ipeet/mte481/README

MTE 481 - Design Project

Authors:
Iain Peet
Rowan Head-Marsden
Jordan Valentin

Overview:
Object avoidance and, potentially, localization and maping for powered wheelchairs.
