ipeet/mte481/Poster/FYDP_Poster.pdf

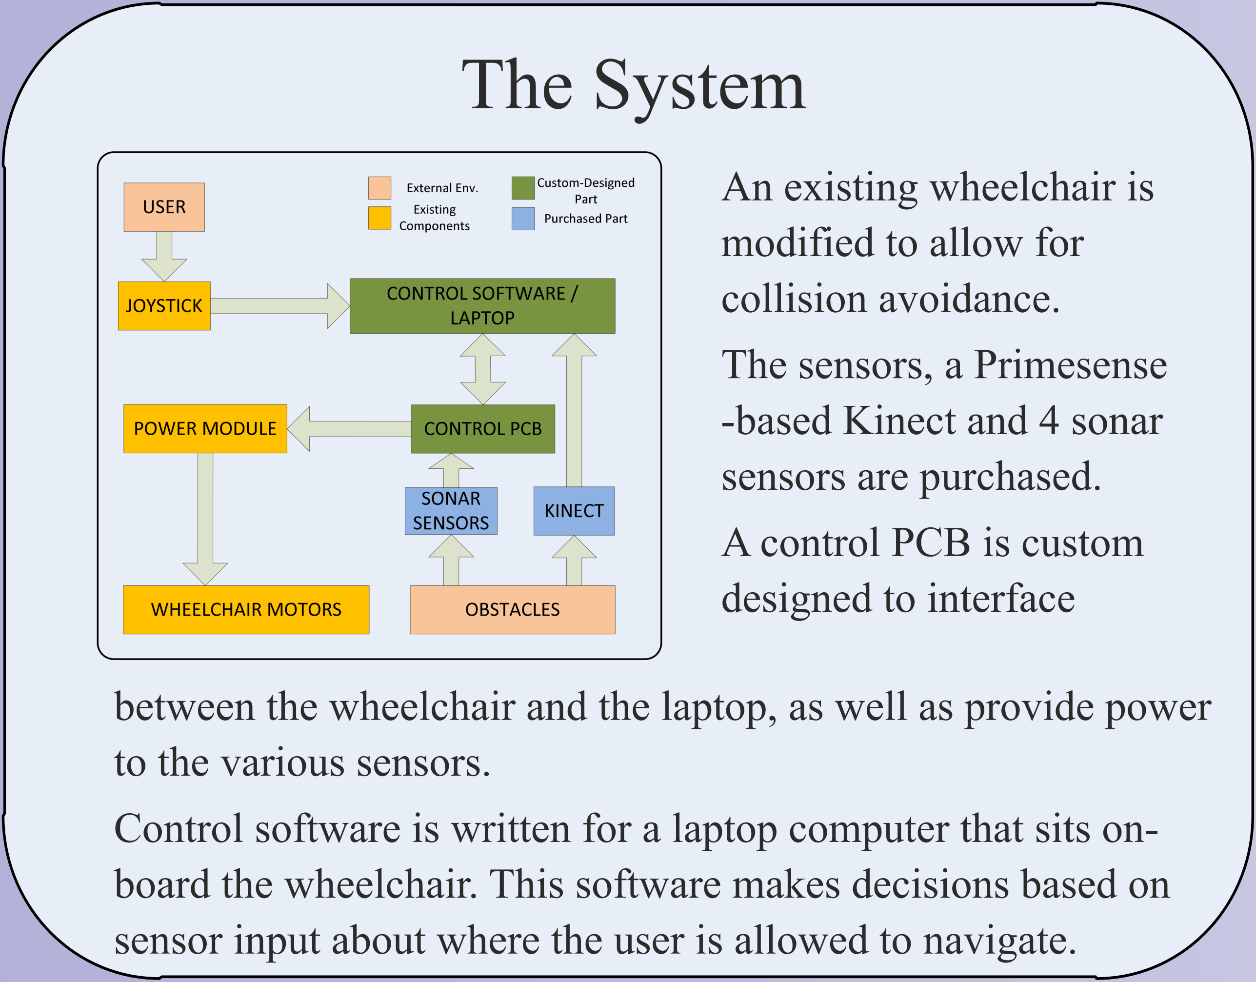
[picture p46: figure]
The System; An existing wheelchair is modified to allow for collision avoidance.; The sensors, a Primesense -based Kinect and 4 sonar sensors are purchased.; A control PCB is custom designed to interface; to the various sensors.
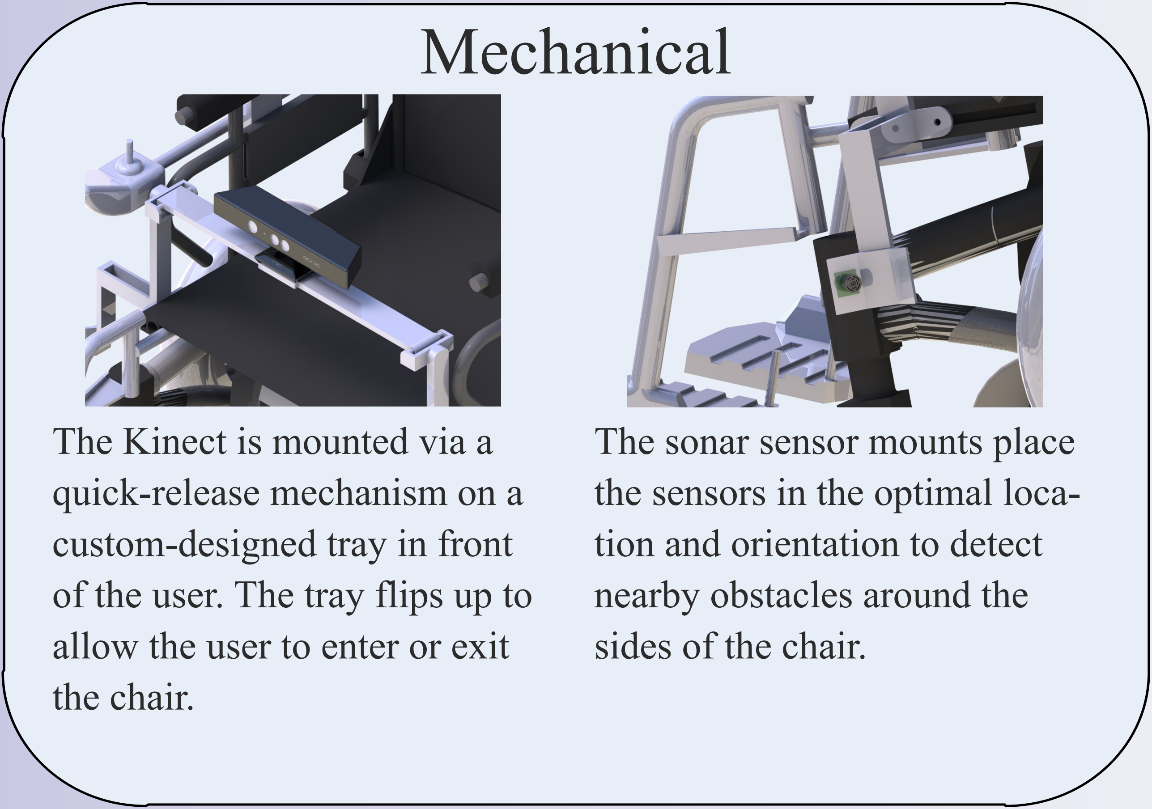
[picture p47: figure]
Mechanical; The Kinect is mounted via a quick-release mechanism on a custom-designed tray in front of the user. The tray flips up to allow the user to enter or exit the chair.; The sonar sensor mounts place the sensors in the optimal loca- tion and orientation to detect nearby obstacles around the sides of the chair.

A visualization of the wheelchair moving down a hallway. Obstacles are represented by white tiles. Requested path in green/red, where the green portion is collisionfree and will be allowed by the software.

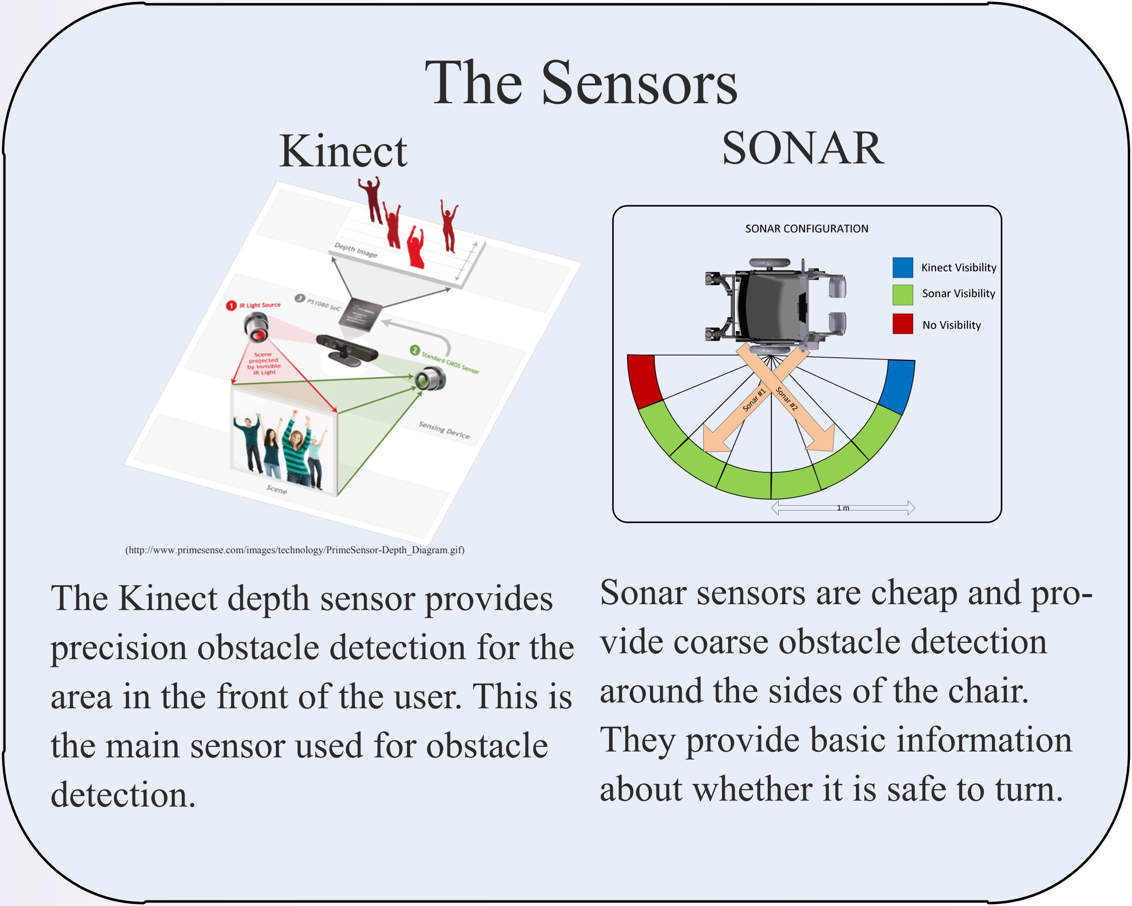
[picture p48: figure]
The Sensors; Kinect; SONAR; The Kinect depth sensor provides precision obstacle detection for the area in the front of the user. This is the main sensor used for obstacle detection.; Sonar sensors are cheap and pro- vide coarse obstacle detection around the sides of the chair. They provide basic information about whether it is safe to turn.; (http://www.primesense.com/images/technology/PrimeSensor-Depth_Diagram.gif)
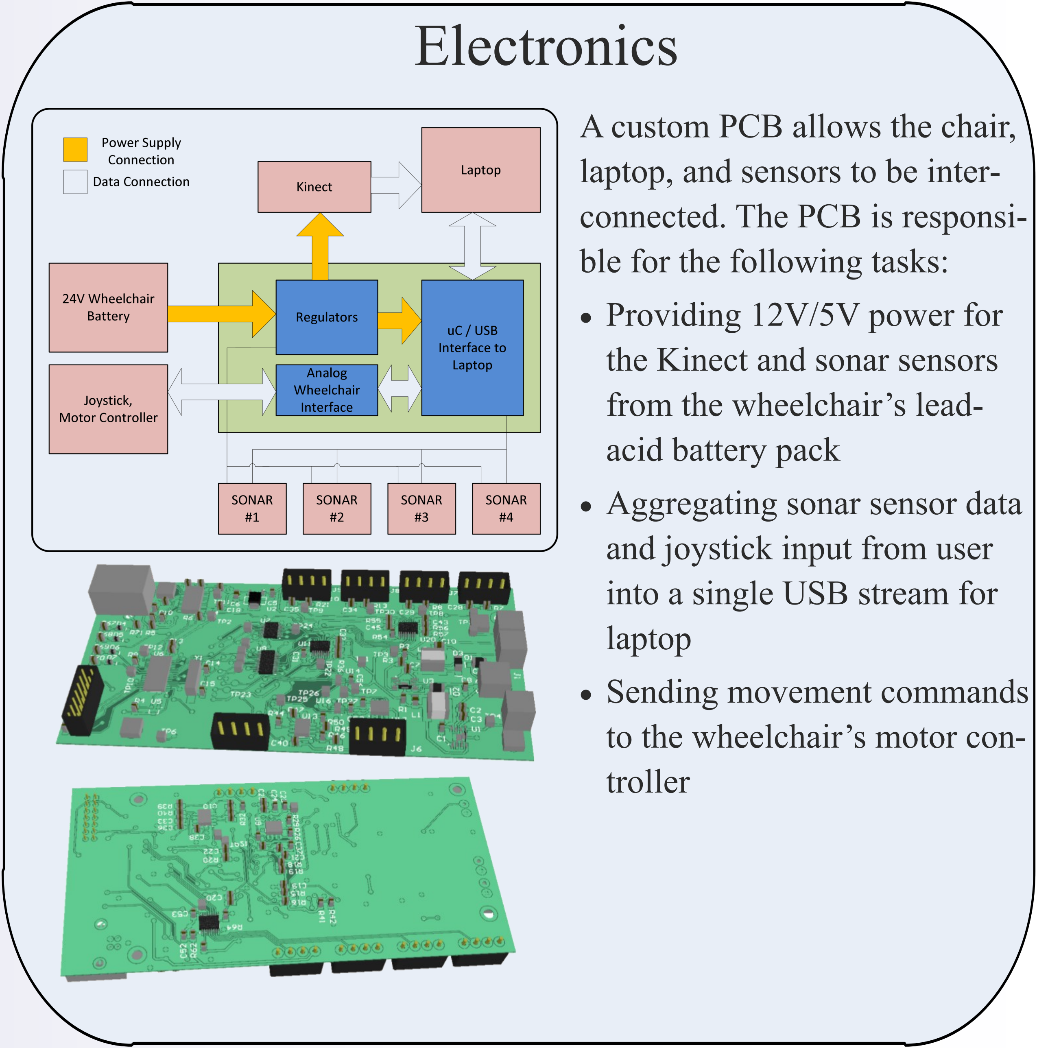
[picture p49: figure]
Electronics; A custom PCB allows the chair, laptop, and sensors to be inter- connected. The PCB is responsi- ble for the following tasks:; Providing 12V/5V power for the Kinect and sonar sensors from the wheelchair’s lead- acid battery pack; Aggregating sonar sensor data and joystick input from user into a single USB stream for laptop; Sending movement commands to the wheelchair’s motor con- troller

# Acknowledgements

Special thanks to Professor Amir Khajepour of the MME Dept. for providing a powered wheelchair for the duration of this project.

## Collision Avoidance System for a Powered Wheelchair

# MTE 482 — Group #2

### Rowan Head-Marsden, Iain Peet, Jordan Valentin

# The Need

# Our Objectives

Powered wheelchairs can greatly improve the mobility and independence of the disabled, but many potential users in care homes are denied access due to safety concerns. Collision avoidance systems are needed for powered chairs to increase safety and allow many more people access to the enhanced quality of life they can provide.

Provide a low-cost system to the end-user — Cost is sensitive to many potential users and powered chairs are expensive enough as it is
Effective collision avoidance — Must be a very dependable system for care homes to consider allowing patients access Integrates with an existing wheelchair model — No need to redesign from scratch

# Software

between the wheelchair and the laptop, as well as provide power

Control software is written for a laptop computer that sits onboard the wheelchair. This software makes decisions based on sensor input about where the user is allowed to navigate.

The software takes the Kinect and sonar input about obstacles in the environment and user commands entered via the joystick. Combined with a model of the wheelchair the path of the chair is predicted and collision checking performed. Movement of the chair is limited based on these collision checks.
