ipeet/mte481/doc/pdp/pdp.pdf

## MTE 481 - Design Project

Object Avoidance and Navigation for Powered Wheelchairs

Iain Peet | Rowan Head-Marsden | Jordan Valentin

October 3, 2011

## Introduction


## Need Statement

Powered wheelchairs can improve the mobility of the physically handicapped, but alertness and control are required for safe operation. Additional assistive technology is needed in order to afford the same benefits to the more severely disabled.

## Objectives & Constraints

I Improve the safety of powered wheelchairs, for the occupand and for nearby pedestrians.

I Make powered wheelchairs accessible to people who would otherwise be denied due to safety concerns.
I Assist wheelchair users with difficult tasks, such as precise positioning and movement in constrained spaces.
I Avoid requiring a specialized, controlled operating environment.
I It must be possible to integrate with existing wheelchairs.

## Criteria

I Risk of human harm.
I Tolerance of human error.

I Robustness against physical damage.
I Ability to operate in a variety of environments.

I Price.
I Electrical power consumption.

## Design Concept

I Use sensor(s) as inputs to a computer-controlled system.

I Take user input into this system.
I Combine the user input and sensor readings to determine output to motor controllers.
I Produce collision-free movement of chair (whether by warnings, automated avoidance, etc.)

## Stereo Vision


## Ultrasonic


## Infra-Red


## RADAR

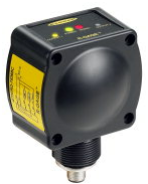
[picture p50: figure]

## LIDAR


## Microsoft Kinect


## Patent Search

“Computer controlled power wheelchair navigation system”


I Patent No. US 7,383,107 B2 (June 3, 2008)

## Patent Search

“Powered Wheelchair”


I Patent No. US 2010/0082182 A1 (April 1, 2010)

## Patent Search

“Wheelchair and method for correcting the guidance of a wheelchair”


I Patent No. US 2011/0130940 A1 (June 2, 2011)

# Questions?
