ipeet/mte481/doc/final/images/FinalSonarMount2.JPG

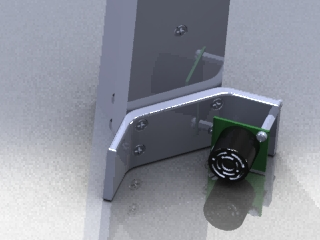
doc/final/images/FinalSonarMount2.JPG
