ipeet/mte481/doc/final/images/FinalSonarMount.jpg

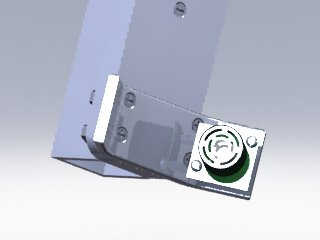
doc/final/images/FinalSonarMount.jpg
