ipeet/mte481/doc/final/images/SONAR_RENDER.png

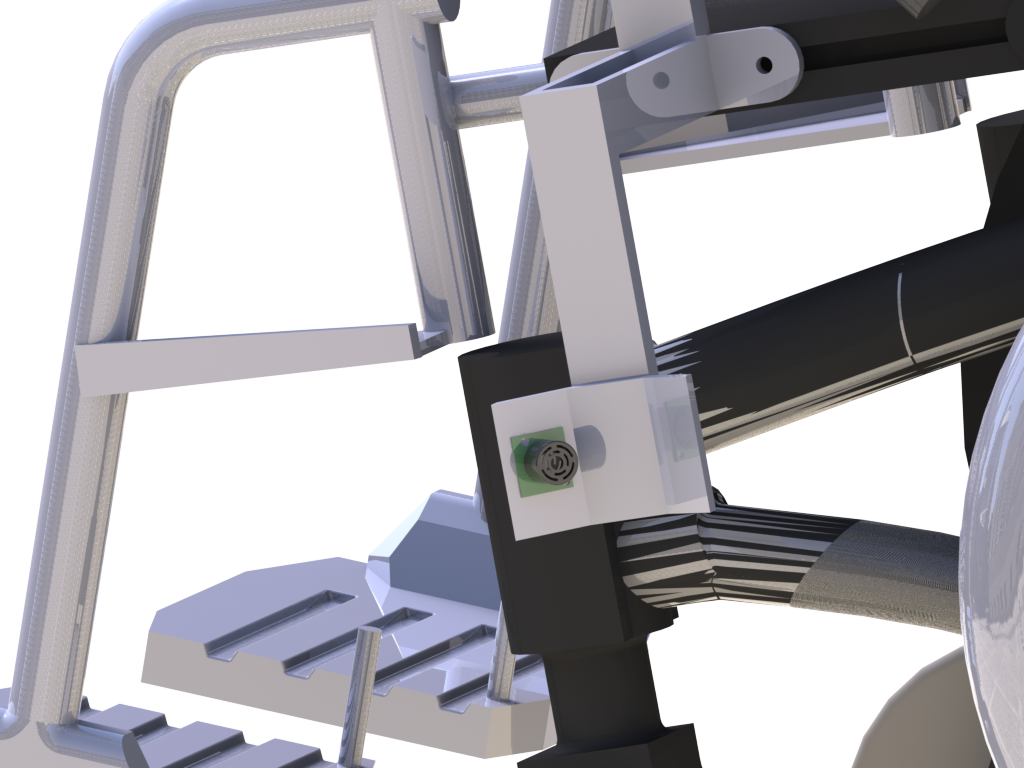
doc/final/images/SONAR_RENDER.png
