ipeet/mte481/doc/final/images/System_Level.png

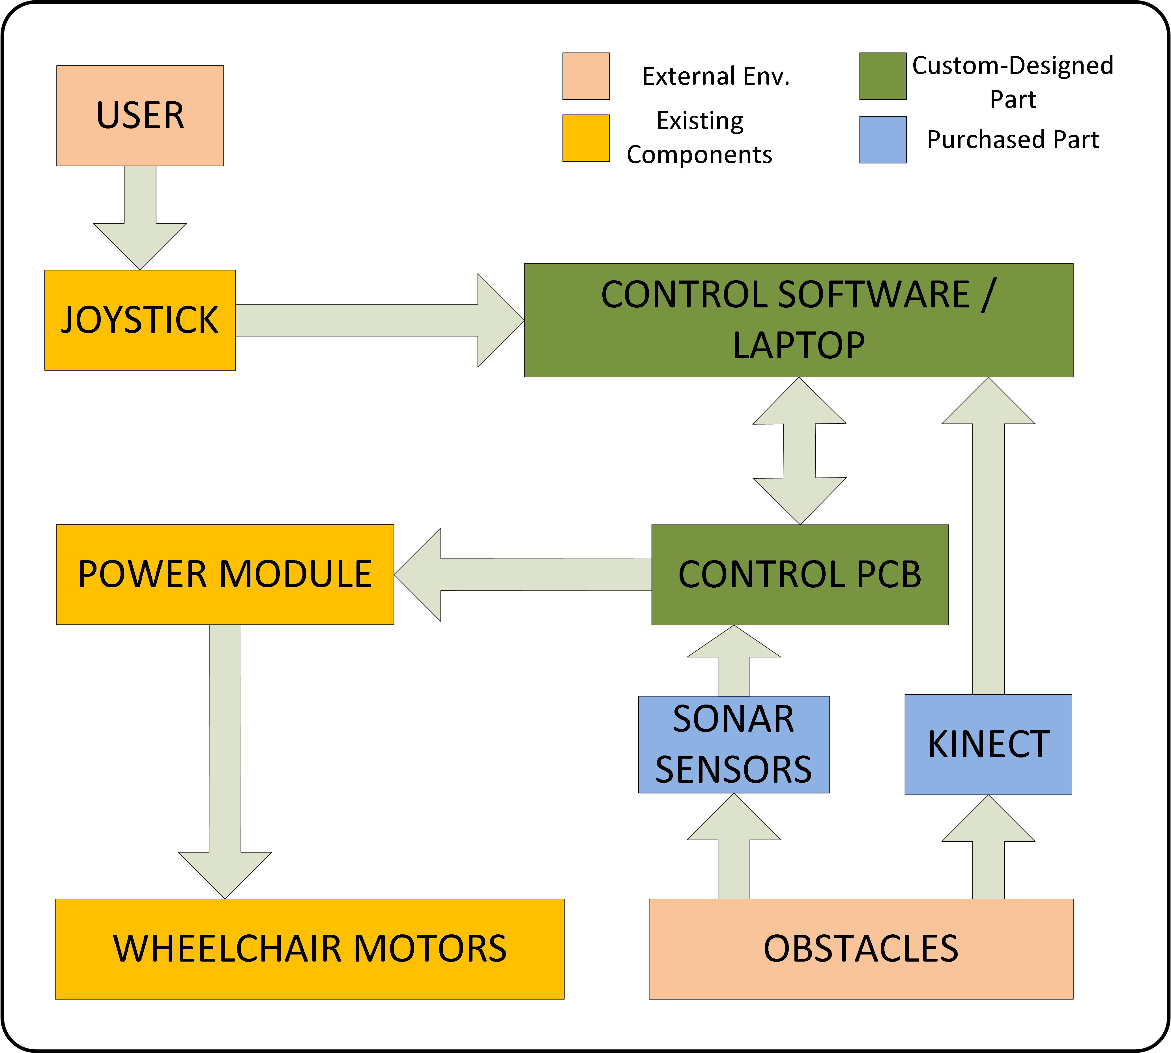
doc/final/images/System_Level.png
