ipeet/mte481/doc/report/images/SonarSensor.jpg

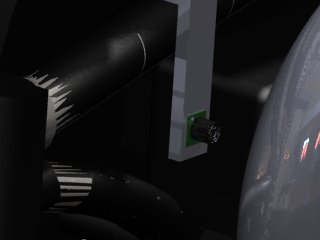
doc/report/images/SonarSensor.jpg
