ipeet/mte481/doc/report/images/WheelChair_CAD.jpg

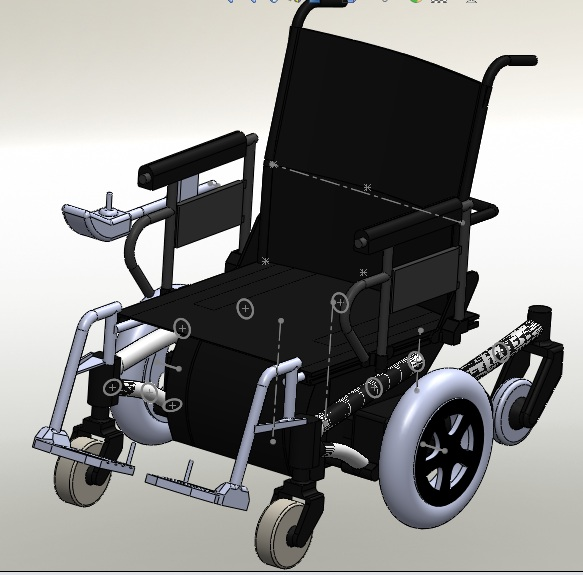
doc/report/images/WheelChair_CAD.jpg
