ipeet/mte481/doc/final/source docs/BOM_Final.xlsx

Sheet: 1U
Part | Count | Cost | Total
Xbox Kinect | 1 | 146.89 | $146.89
Xbox Kinect Mount | 1 | 30 | $30
Sonar Sensor | 4 | 34.59 | $138.36
Sheet Metal (sq ft) | 1 | 50 | $50
PCB | 1 | 72 | $72
PCB Components | 1 | 43.5 | $43.5
Basic Netbook | 1 | 350 | $350
Total |  |  | $830.75

Sheet: 1KU
Part | Count | Cost | Total
Xbox Kinect | 1 | 146.89 | $146.89
Xbox Kinect Mount | 1 | 30 | $30
Sonar Sensor | 4 | 34.59 | $138.36
Sheet Metal (sq ft) | 1 | 50 | $50
PCB | 1 | 10 | $10
PCB Components | 1 | 20 | $20
High-Level Processor | 1 | 35 | $35
Total |  |  | $430.25
