ipeet/mte481/doc/report/source_documents/BOM.xlsx

Part | Count | Cost | Total
Xbox Kinect | 1 | 150 | $150
Xbox Kinect Mount | 1 | 15 | $15
Sonar Sensor | 4 | 30 | $120
Sheet Metal (sq foot) | 4 | 3 | $12
Spacers | 8 | 0.25 | $2
PCB + Components | 1 | 150 | $120
Basic Netbook | 1 | 350 | $350
Total |  |  | $769
