ipeet/mte481/wheelChair_Model/Wheel Chair.SLDASM

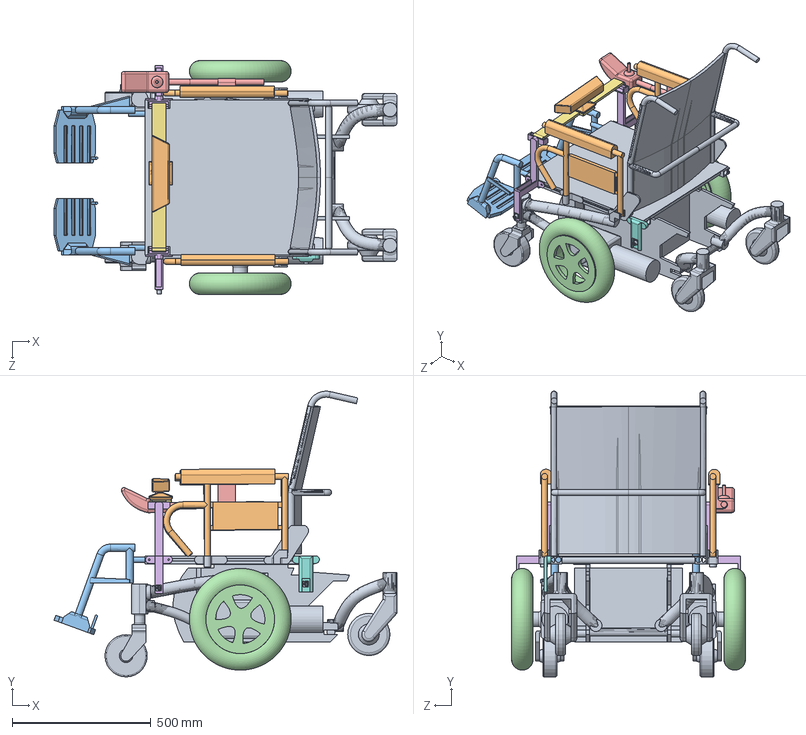
[picture p57: CAD file, 2012-03-24]
wheelChair_Model/Wheel Chair.SLDASM
1237.0 x 1031.0 x 844.0 mm
Wheel Chair Chair
Wheel Chair Arms x 2
Wheel Chair foot Rest Left
Wheel Chair Wheel x 2
Wheel Chair Controller
Right End x 2
Table
Left End
Sonar Sensor x 2
Kinect
