ipeet/mte481/wheelChair_Model/Wheel Chair Model2.SLDASM

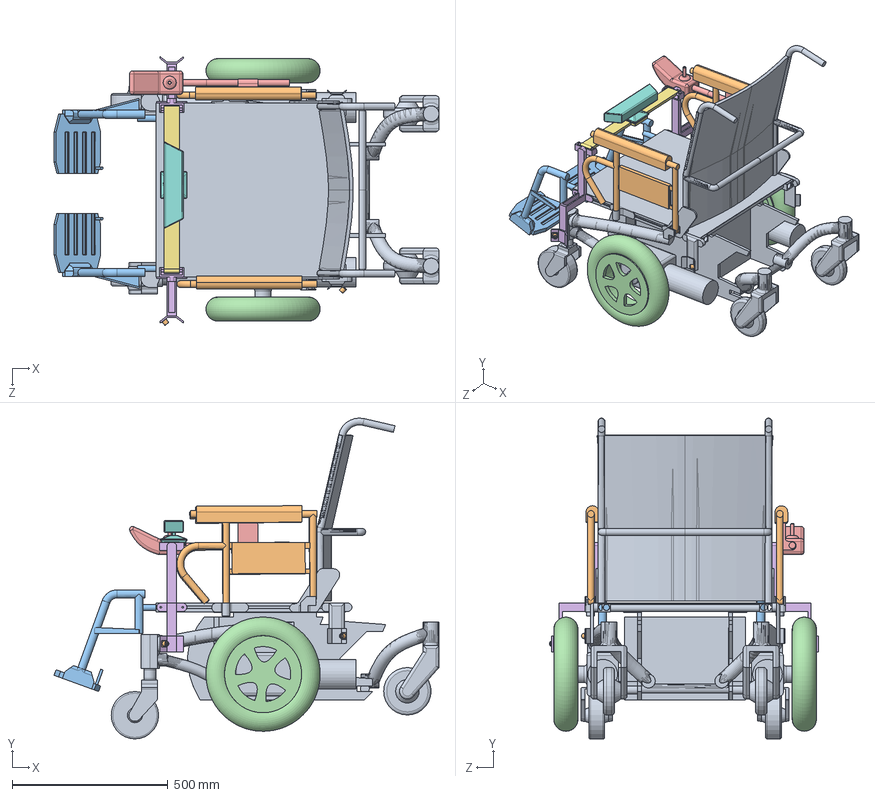
[picture p58: CAD file, 2012-03-24]
wheelChair_Model/Wheel Chair Model2.SLDASM
1237.0 x 1031.0 x 864.1 mm
Wheel Chair Chair
Wheel Chair Arms x 2
Wheel Chair foot Rest Left
Wheel Chair Wheel x 2
Wheel Chair Controller
Right End x 2
Table
Kinect
Left End x 2
Sonar Sensor x 2
