ipeet/mte481/wheelChair_Model/Wheel Chair2.SLDASM

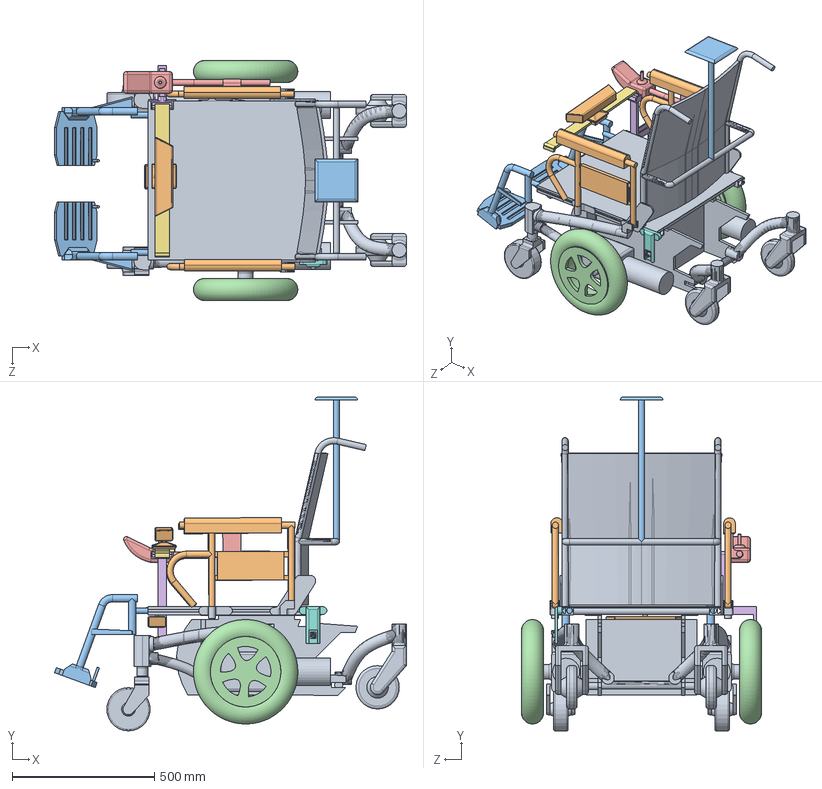
[picture p59: CAD file, 2012-03-24]
wheelChair_Model/Wheel Chair2.SLDASM
1237.0 x 1173.3 x 844.0 mm
Wheel Chair Chair
Wheel Chair Arms x 2
Wheel Chair foot Rest Left
Wheel Chair Wheel x 2
Wheel Chair Controller
Kinect
