ipeet/mte481/wheelChair_Model/RPM1.SLDPRT

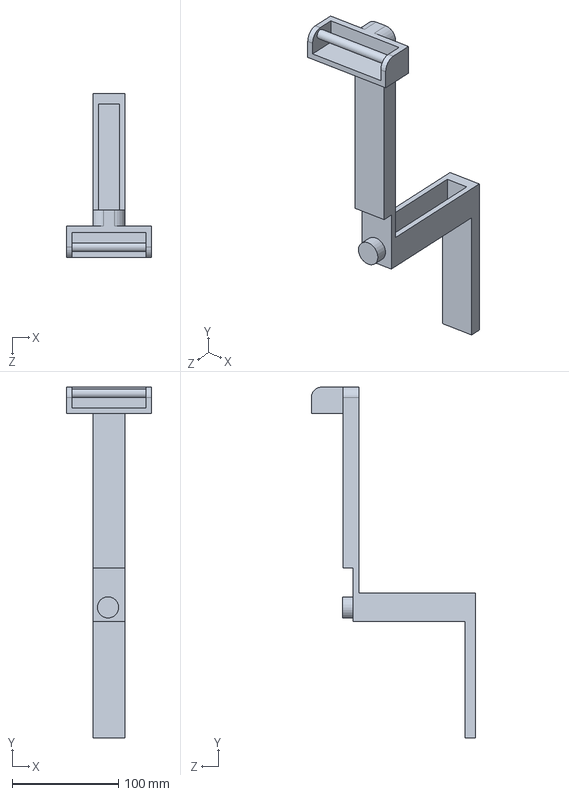
[picture p60: CAD file, 2012-03-24]
wheelChair_Model/RPM1.SLDPRT
80.0 x 330.8 x 155.0 mm
