ipeet/mte481/wheelChair_Model/Wheel Chair Wheel.SLDPRT

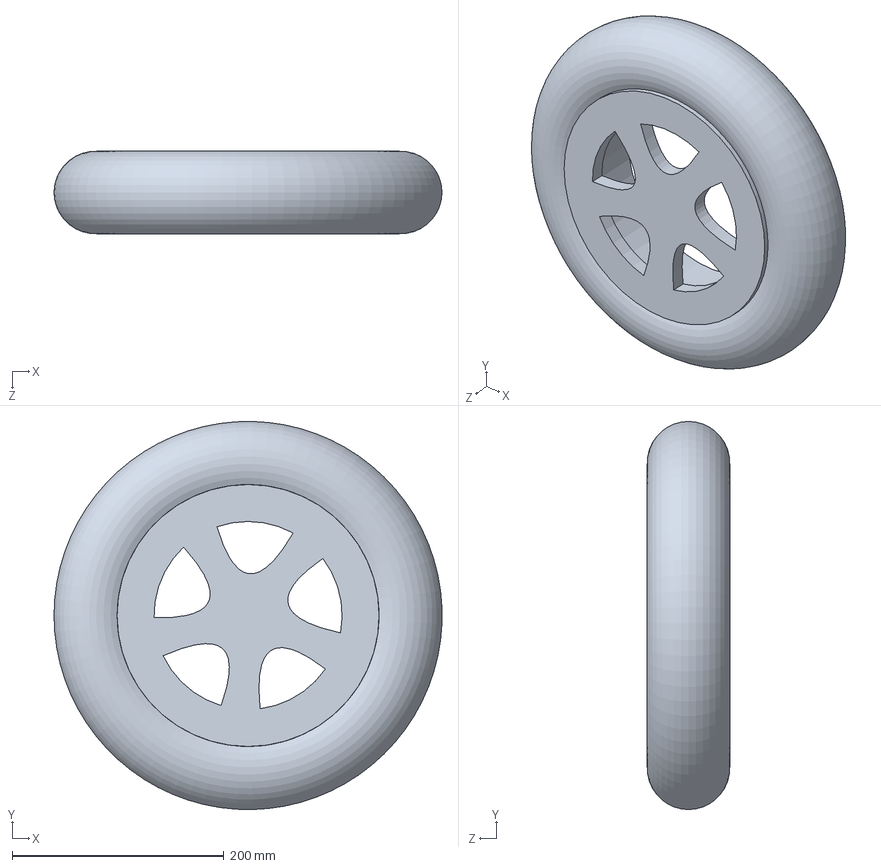
[picture p61: CAD file, 2012-03-24]
wheelChair_Model/Wheel Chair Wheel.SLDPRT
366.8 x 366.9 x 78.0 mm
