ipeet/mte481/wheelChair_Model/Table.SLDPRT

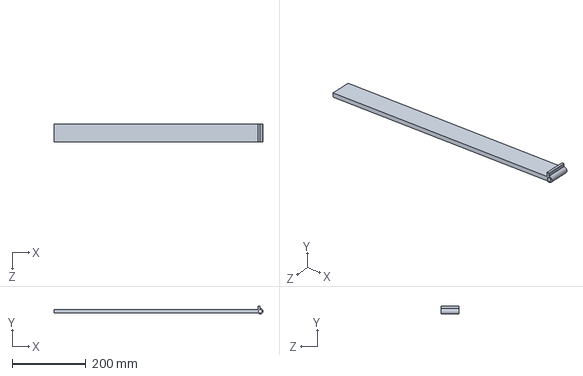
[picture p62: CAD file, 2012-03-24]
wheelChair_Model/Table.SLDPRT
566.3 x 22.0 x 50.0 mm
