ipeet/mte481/wheelChair_Model/Right End.SLDPRT

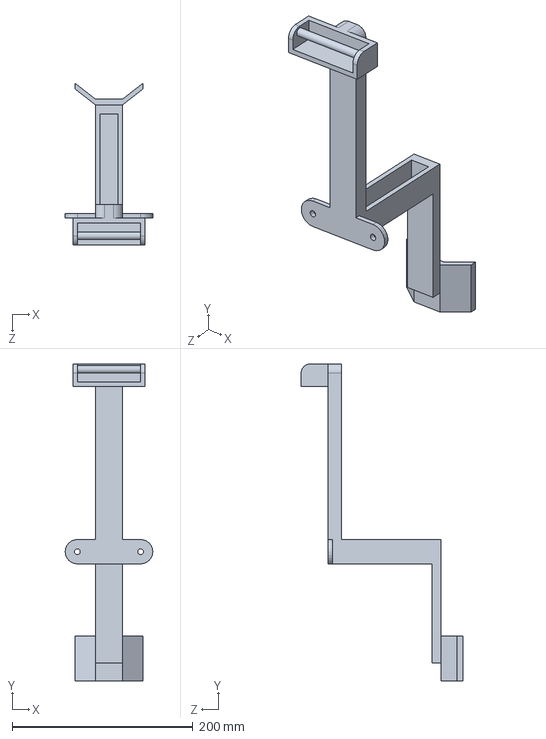
[picture p63: CAD file, 2012-03-24]
wheelChair_Model/Right End.SLDPRT
97.0 x 350.8 x 179.1 mm
