ipeet/mte481/wheelChair_Model/Left End.SLDPRT

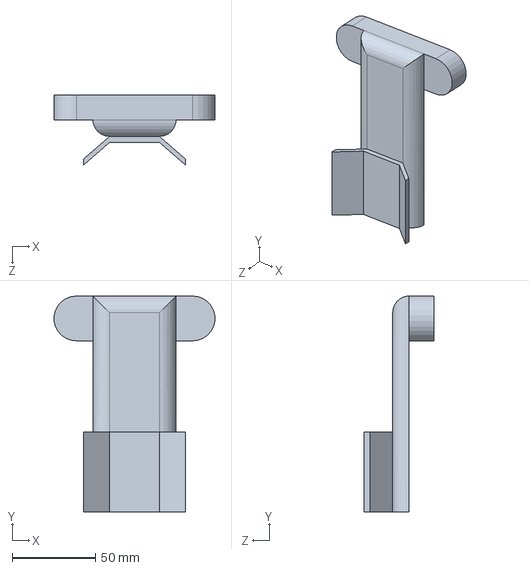
[picture p64: CAD file, 2012-03-24]
wheelChair_Model/Left End.SLDPRT
96.8 x 130.0 x 42.3 mm
