ipeet/mte481/wheelChair_Model/Wheel Chair foot Rest Left.SLDPRT

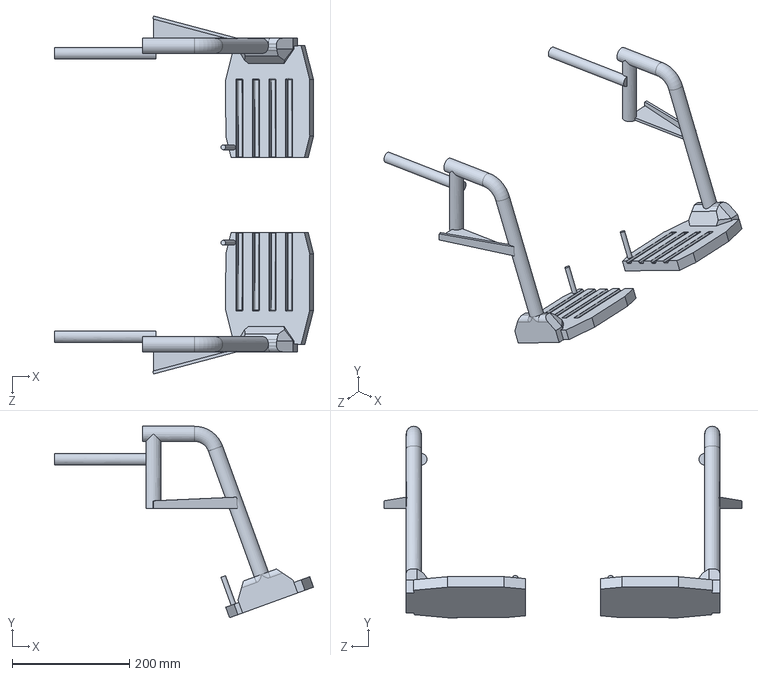
[picture p65: CAD file, 2012-03-24]
wheelChair_Model/Wheel Chair foot Rest Left.SLDPRT
442.0 x 326.6 x 610.6 mm
