ipeet/mte481/wheelChair_Model/Wheel Chair Controller.SLDPRT

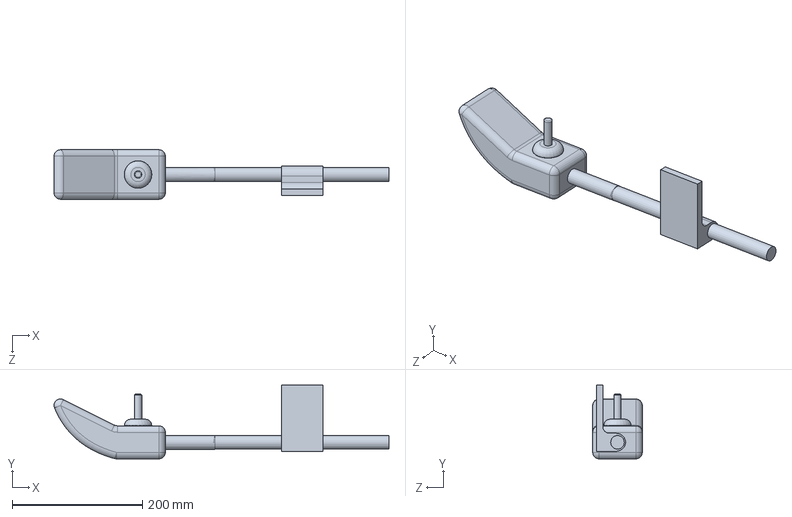
[picture p66: CAD file, 2012-03-24]
wheelChair_Model/Wheel Chair Controller.SLDPRT
513.8 x 113.2 x 76.2 mm
