ipeet/mte481/wheelChair_Model/Sonar Sensor.SLDPRT

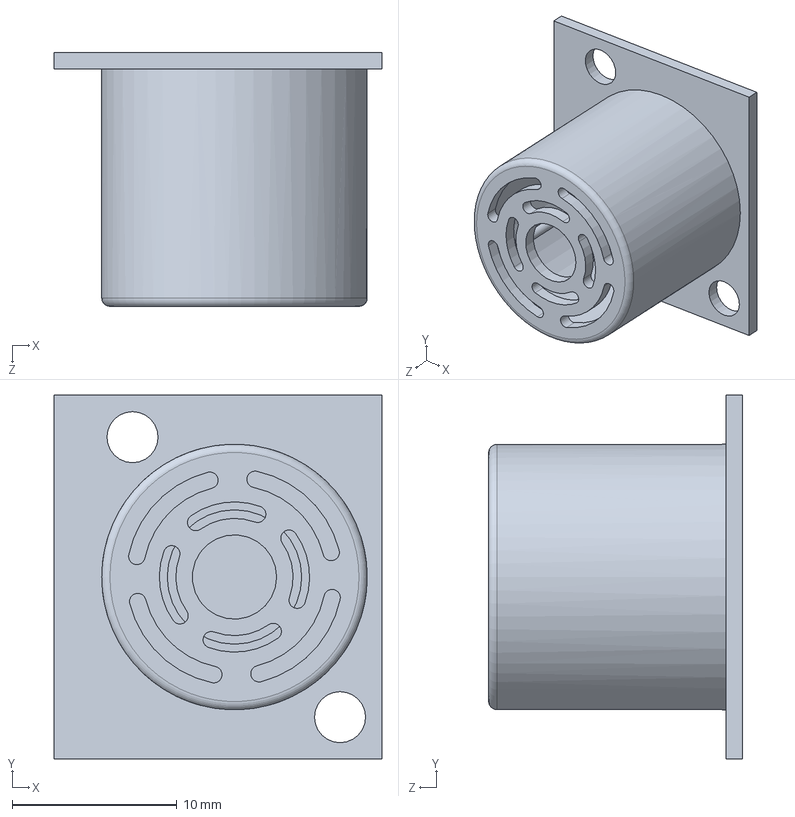
[picture p67: CAD file, 2012-03-24]
wheelChair_Model/Sonar Sensor.SLDPRT
19.9 x 22.1 x 15.4 mm
