ipeet/mte481/wheelChair_Model/Wheel Chair Arms.SLDPRT

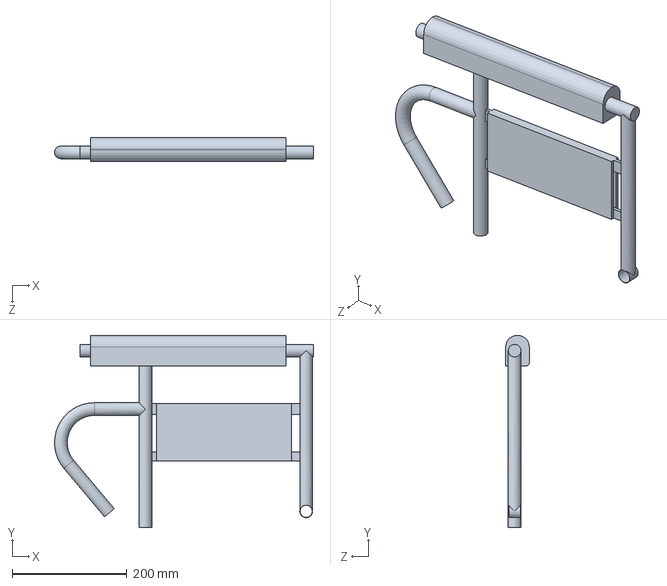
[picture p68: CAD file, 2012-03-24]
wheelChair_Model/Wheel Chair Arms.SLDPRT
450.5 x 334.4 x 41.2 mm
