ipeet/mte481/wheelChair_Model/RPM2.SLDPRT

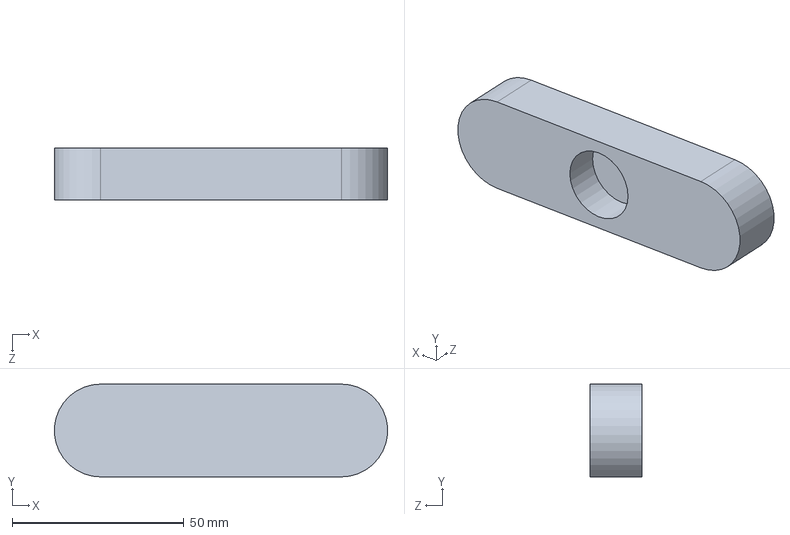
[picture p69: CAD file, 2012-03-24]
wheelChair_Model/RPM2.SLDPRT
96.9 x 27.0 x 15.0 mm
