ipeet/mte481/wheelChair_Model/Kinect.SLDPRT

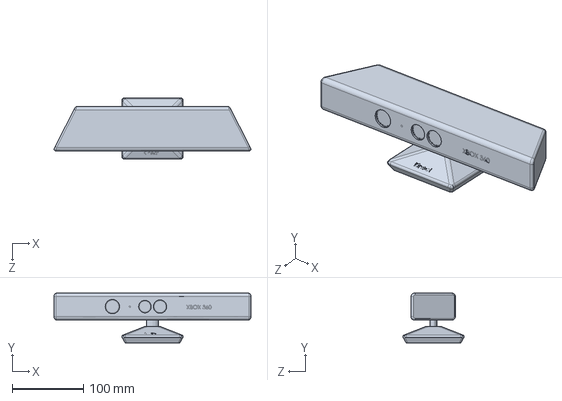
[picture p70: CAD file, 2012-03-24]
wheelChair_Model/Kinect.SLDPRT
276.2 x 70.0 x 85.8 mm
