ipeet/mte481/wheelChair_Model/Wheel Chair Chair.SLDPRT

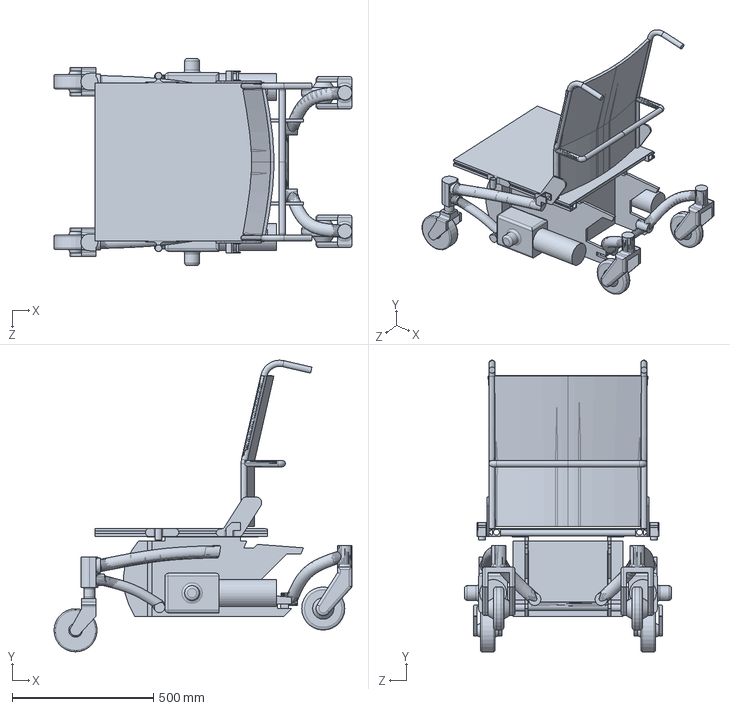
[picture p71: CAD file, 2012-03-24]
wheelChair_Model/Wheel Chair Chair.SLDPRT
1053.2 x 1031.0 x 732.5 mm
