ipeet/mte481/wheelChair_Model/Wheel Chair foot Rest.SLDPRT

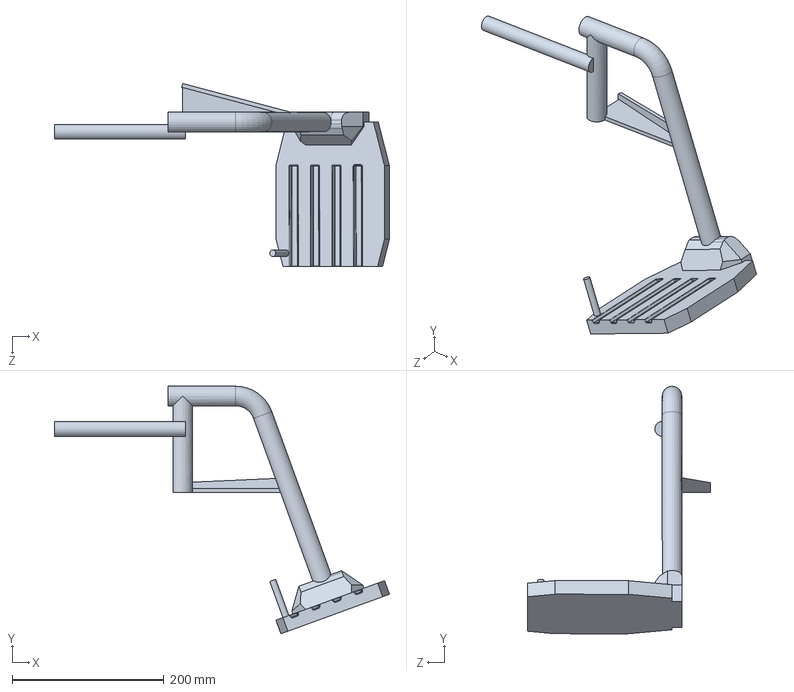
[picture p72: CAD file, 2011-11-13]
wheelChair_Model/Wheel Chair foot Rest.SLDPRT
442.0 x 326.6 x 241.5 mm
