ipeet/mte481/(list of files, cad)

Other CAD files:
wheelChair_Model/Left End.SLDDRW
wheelChair_Model/Right End.SLDDRW
wheelChair_Model/Table.SLDDRW
