ipeet/mte481/doc/fdp/Testing_Pics/P1010010.JPG

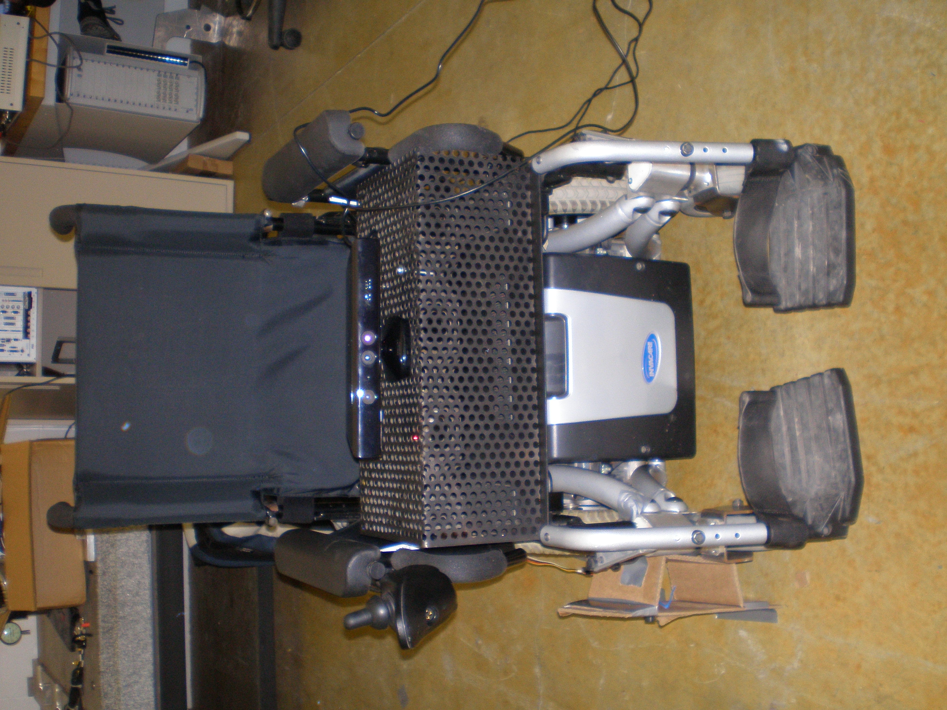
doc/fdp/Testing_Pics/P1010010.JPG
