ipeet/mte481/doc/fdp/Testing_Pics/P1010011.JPG

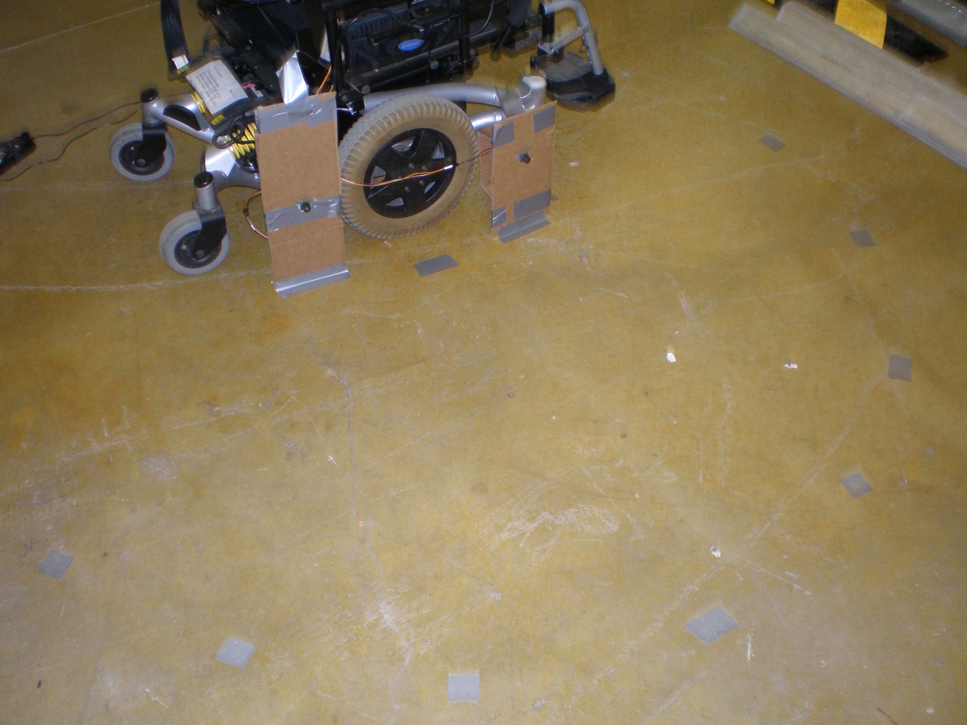
doc/fdp/Testing_Pics/P1010011.JPG
