ipeet/mte481/doc/fdp/Testing_Pics/P1010012.JPG

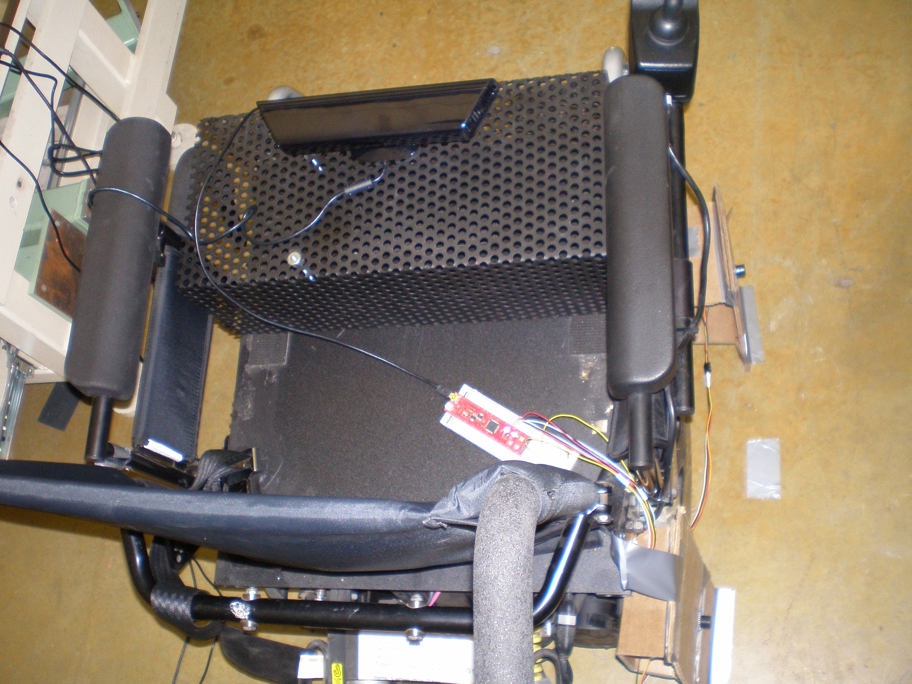
doc/fdp/Testing_Pics/P1010012.JPG
