ipeet/mte481/doc/fdp/Testing_Pics/P1010013.JPG

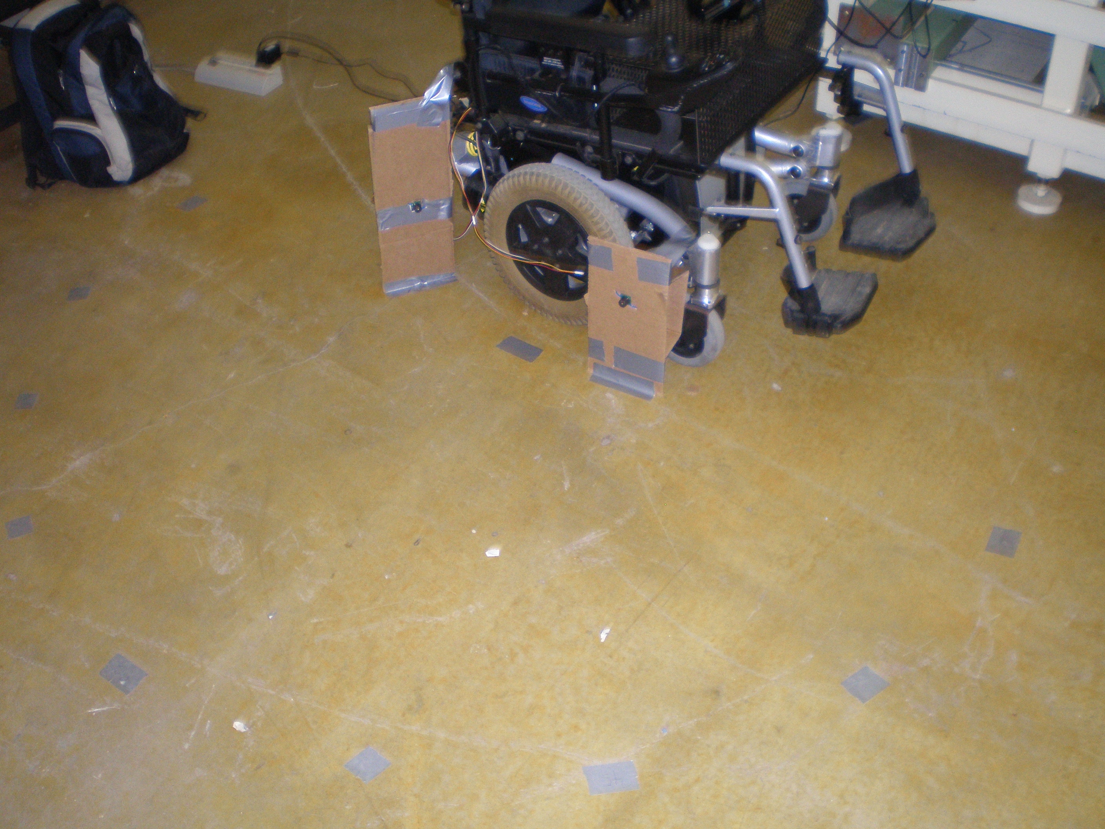
doc/fdp/Testing_Pics/P1010013.JPG
