ipeet/mte481/doc/fdp/Testing_Pics/P1010014.JPG

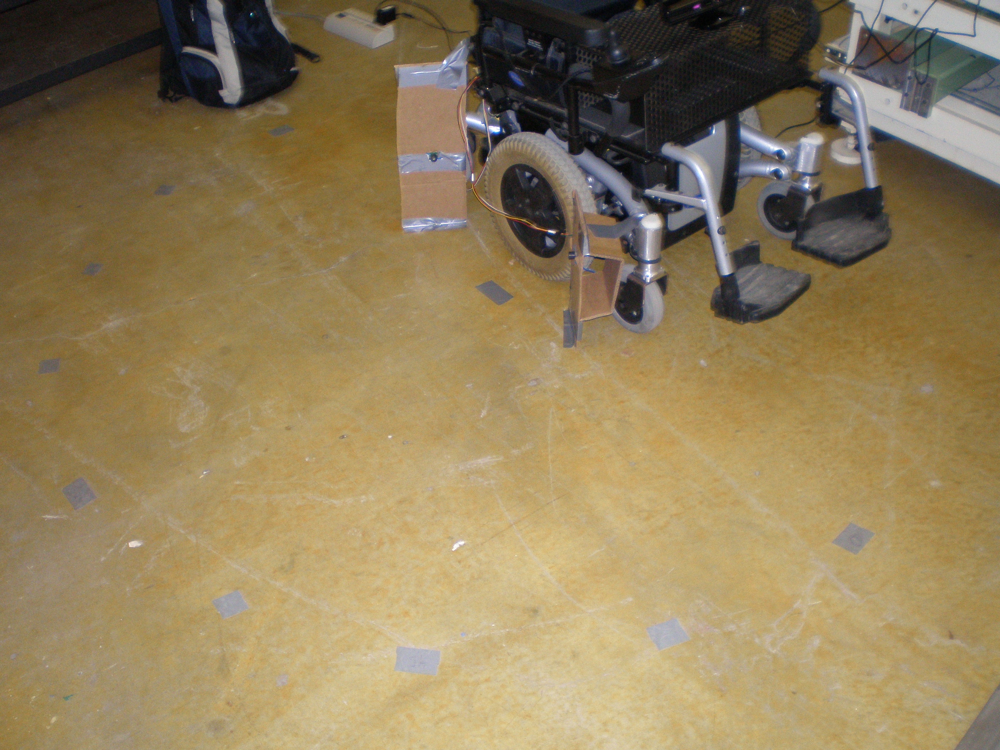
doc/fdp/Testing_Pics/P1010014.JPG
