ipeet/mte481/doc/final/appendices/FYDP_Schematic_Sheet_1.pdf

## Power From Lead Acid Batteries (24V)

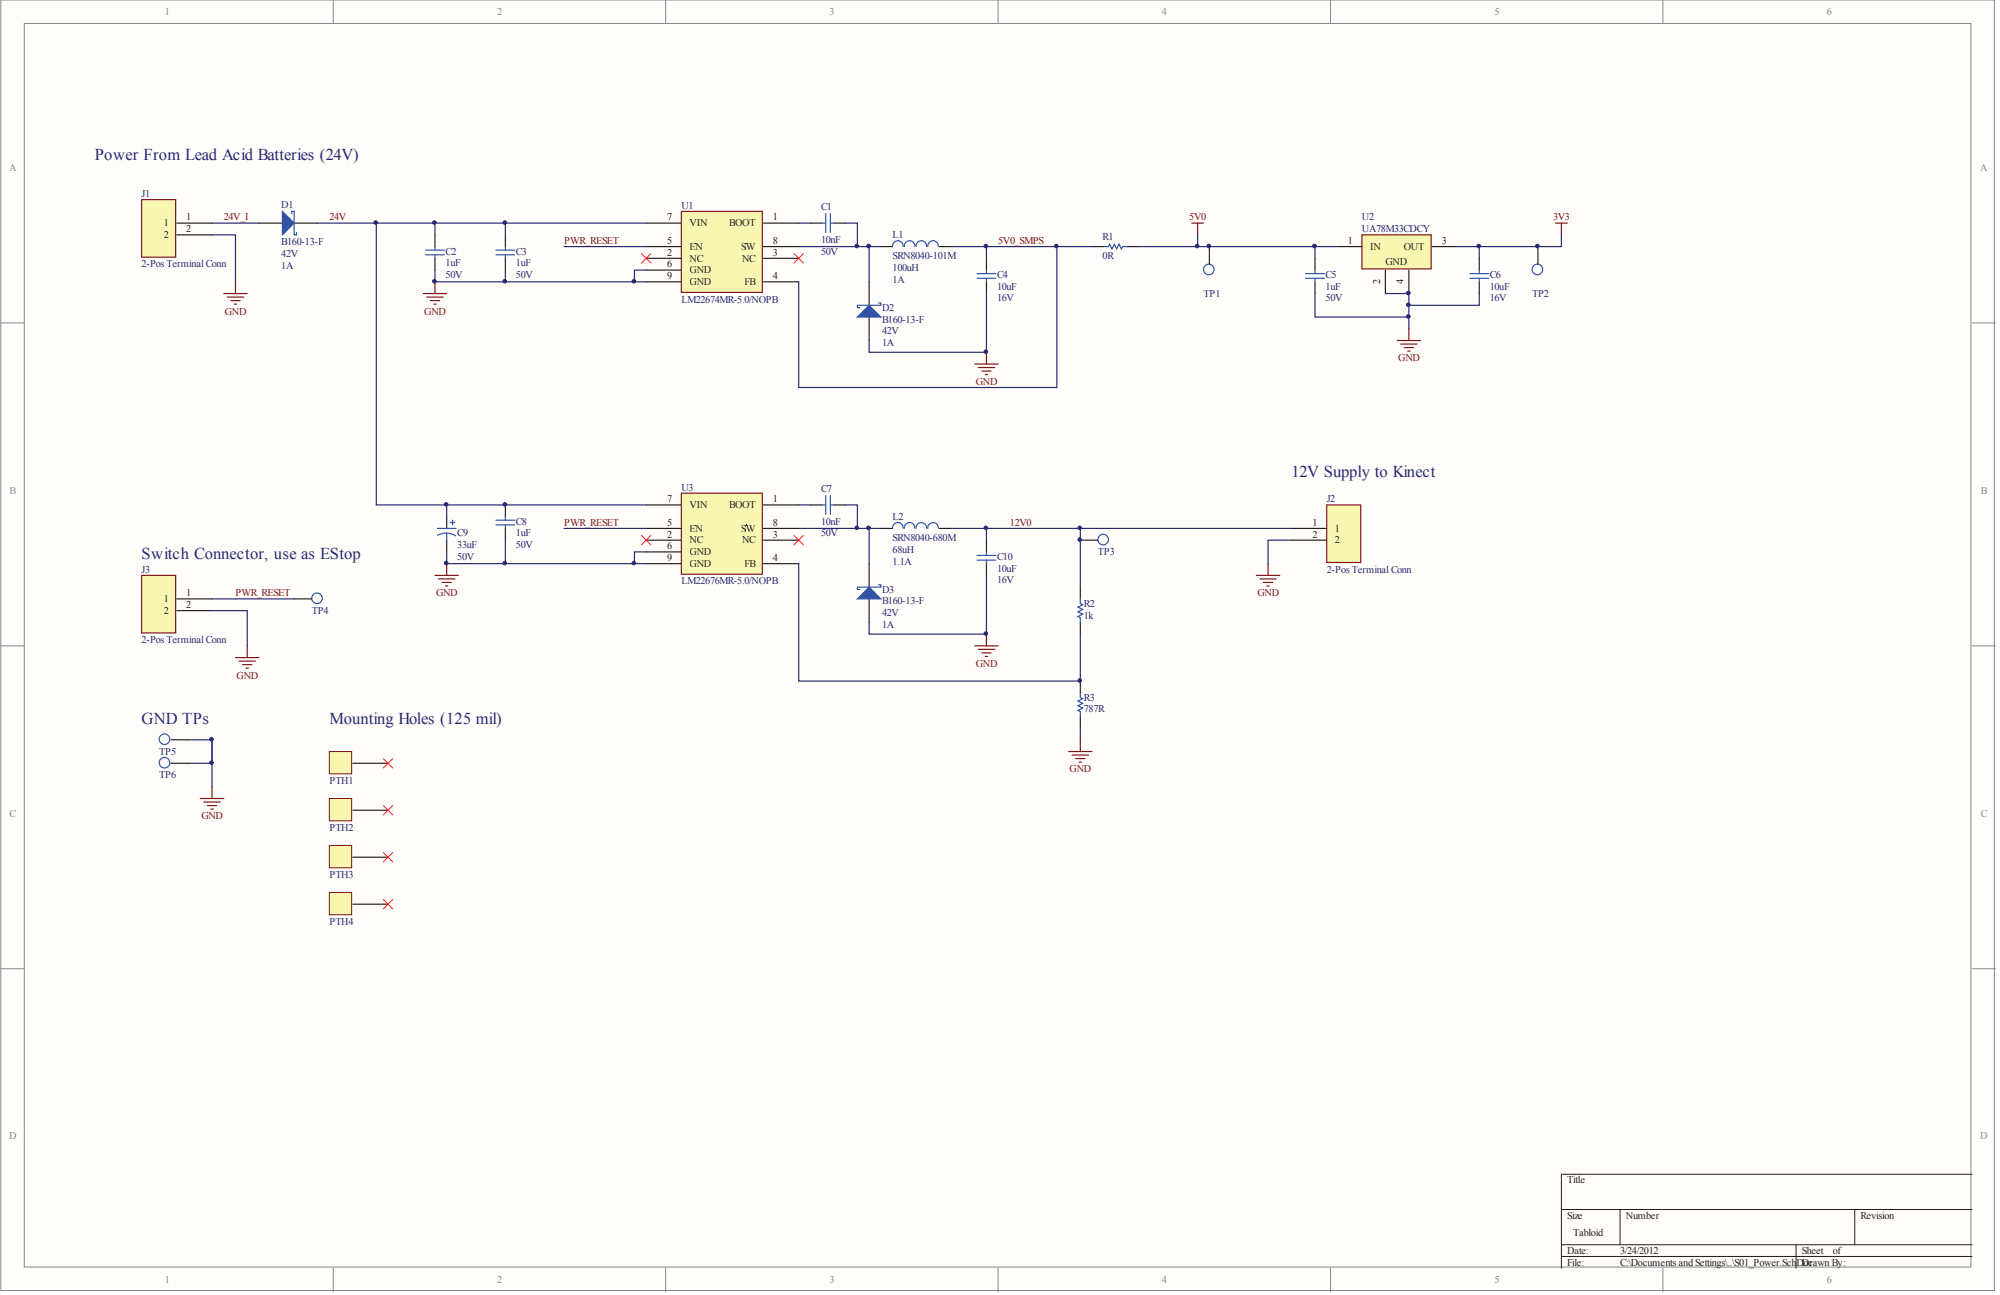
[picture p78: page 1]

Switch Connector, use as EStop
