ipeet/mte481/doc/final/appendices/FYDP_Schematic_Sheet_2.pdf

## USB to UART Converter

## MSP430 Microcontroller

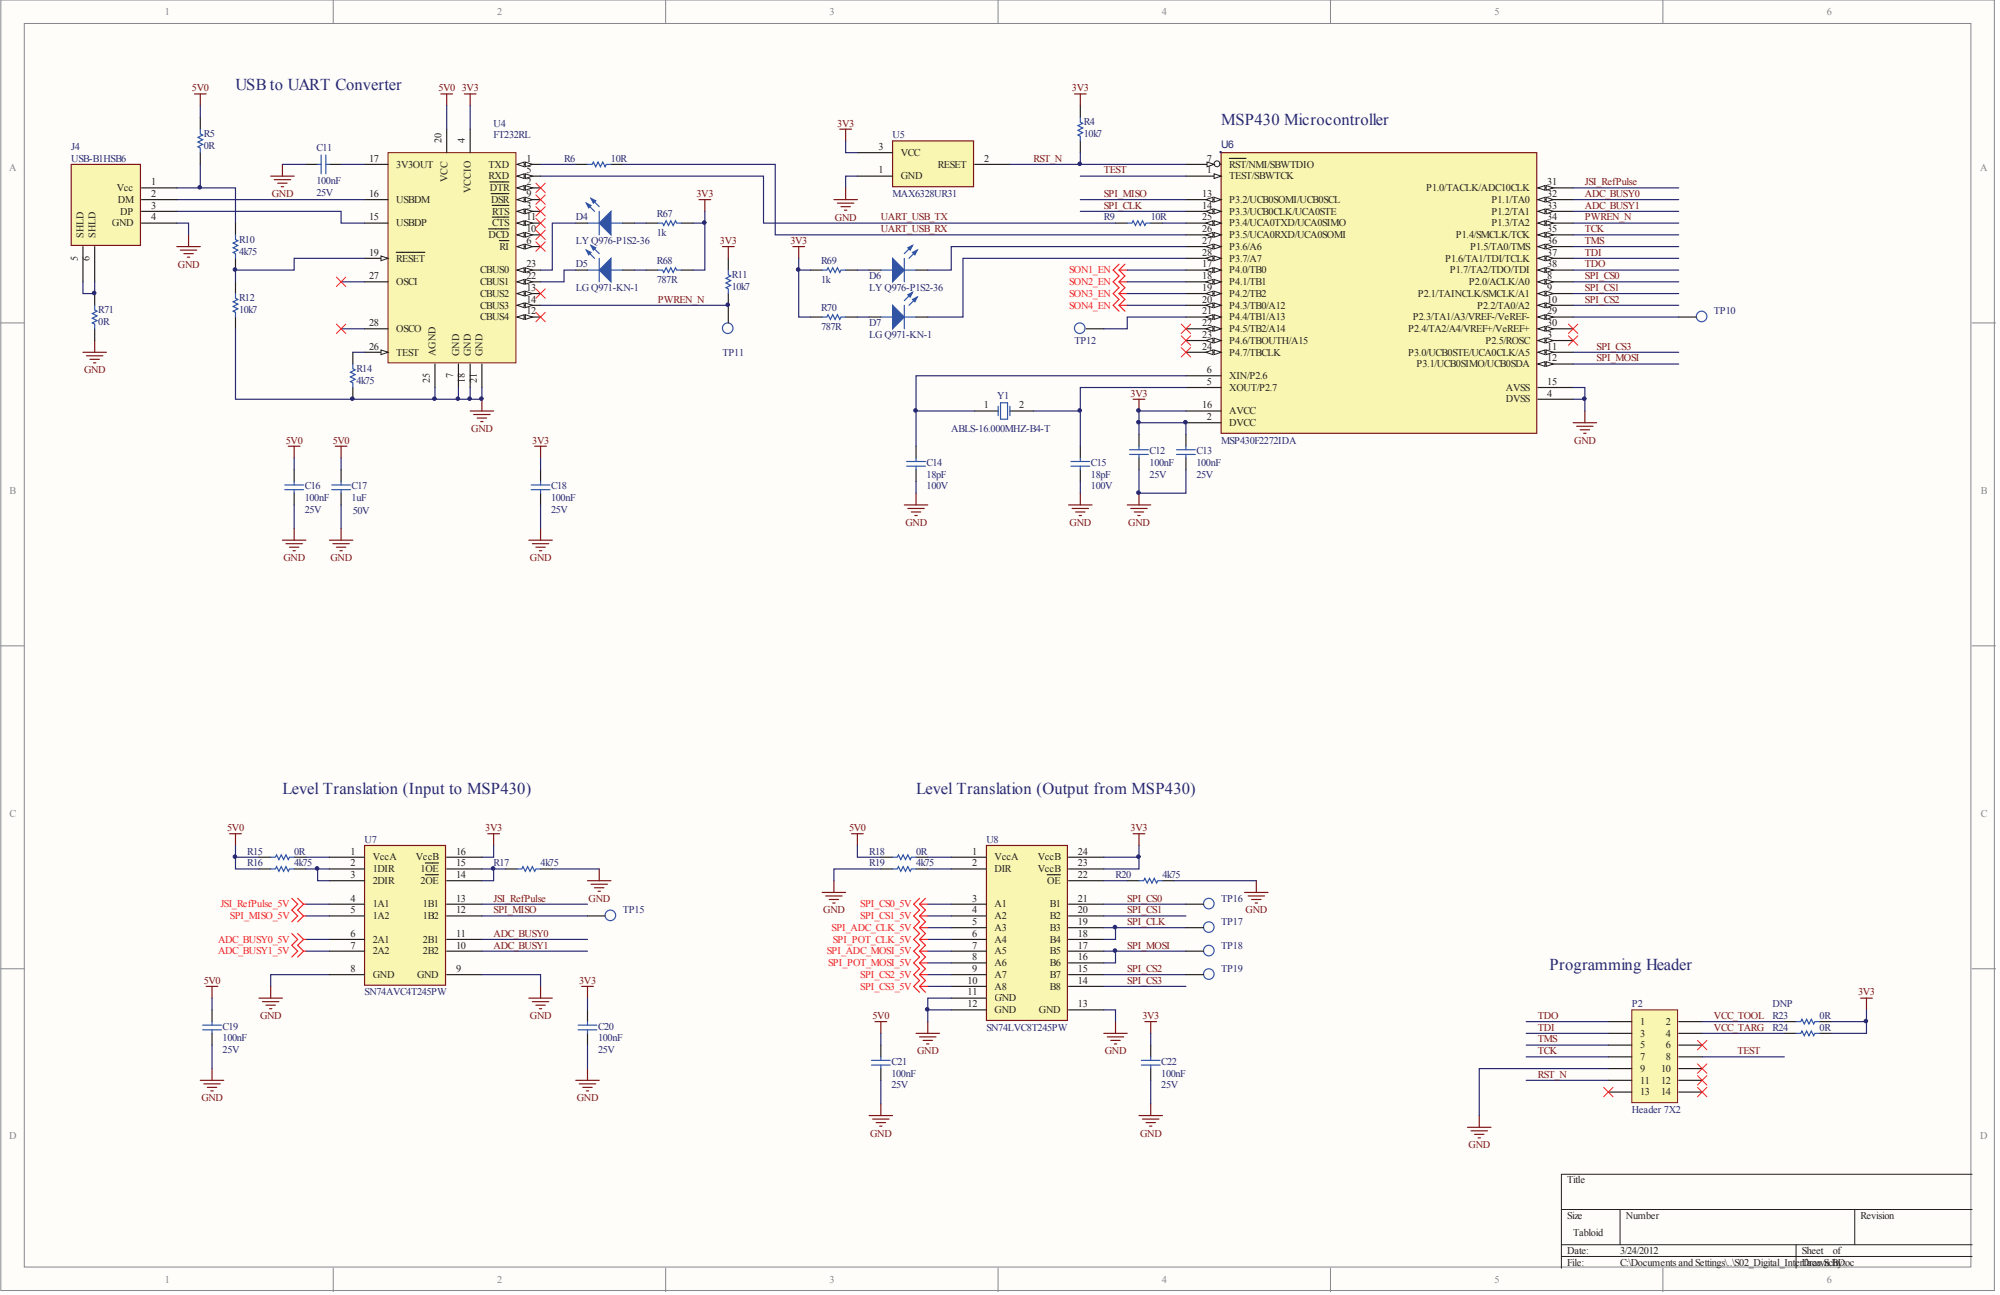
[picture p79: page 1]
