ipeet/mte481/doc/final/appendices/FYDP_Schematic_Sheet_3.pdf

# 1.92 kHz Hi-Pass 192 kHz Lo-Pass V⁺

## Joystick Input Connector

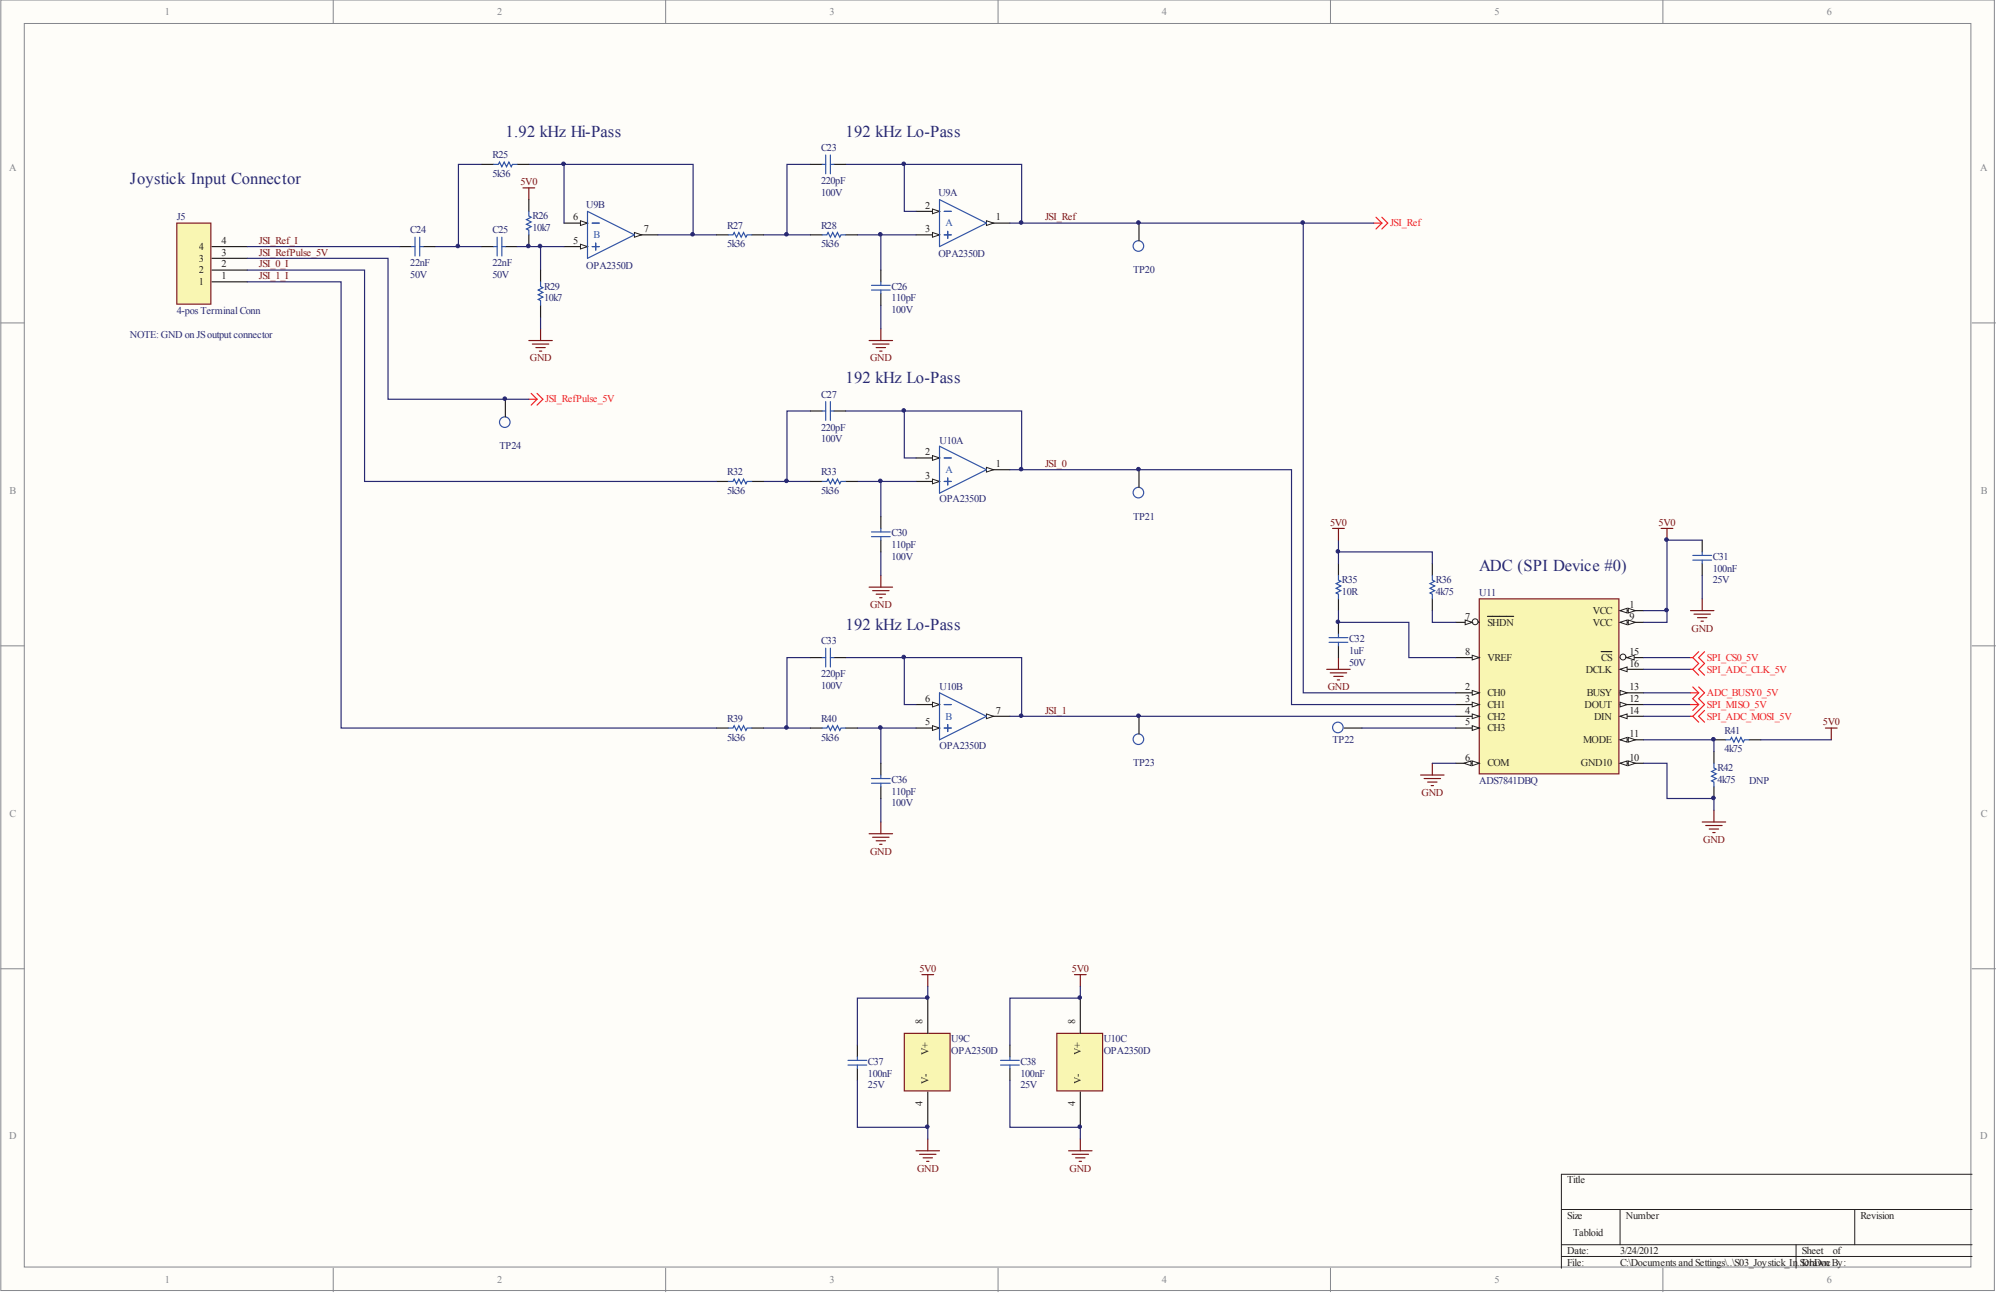
[picture p80: page 1]

NOTE: GND on JS output connector
