ipeet/mte481/doc/final/appendices/FYDP_Schematic_Sheet_4.pdf

## DIGITAL POT (SPI Device #2)

## Joystick Input Connector

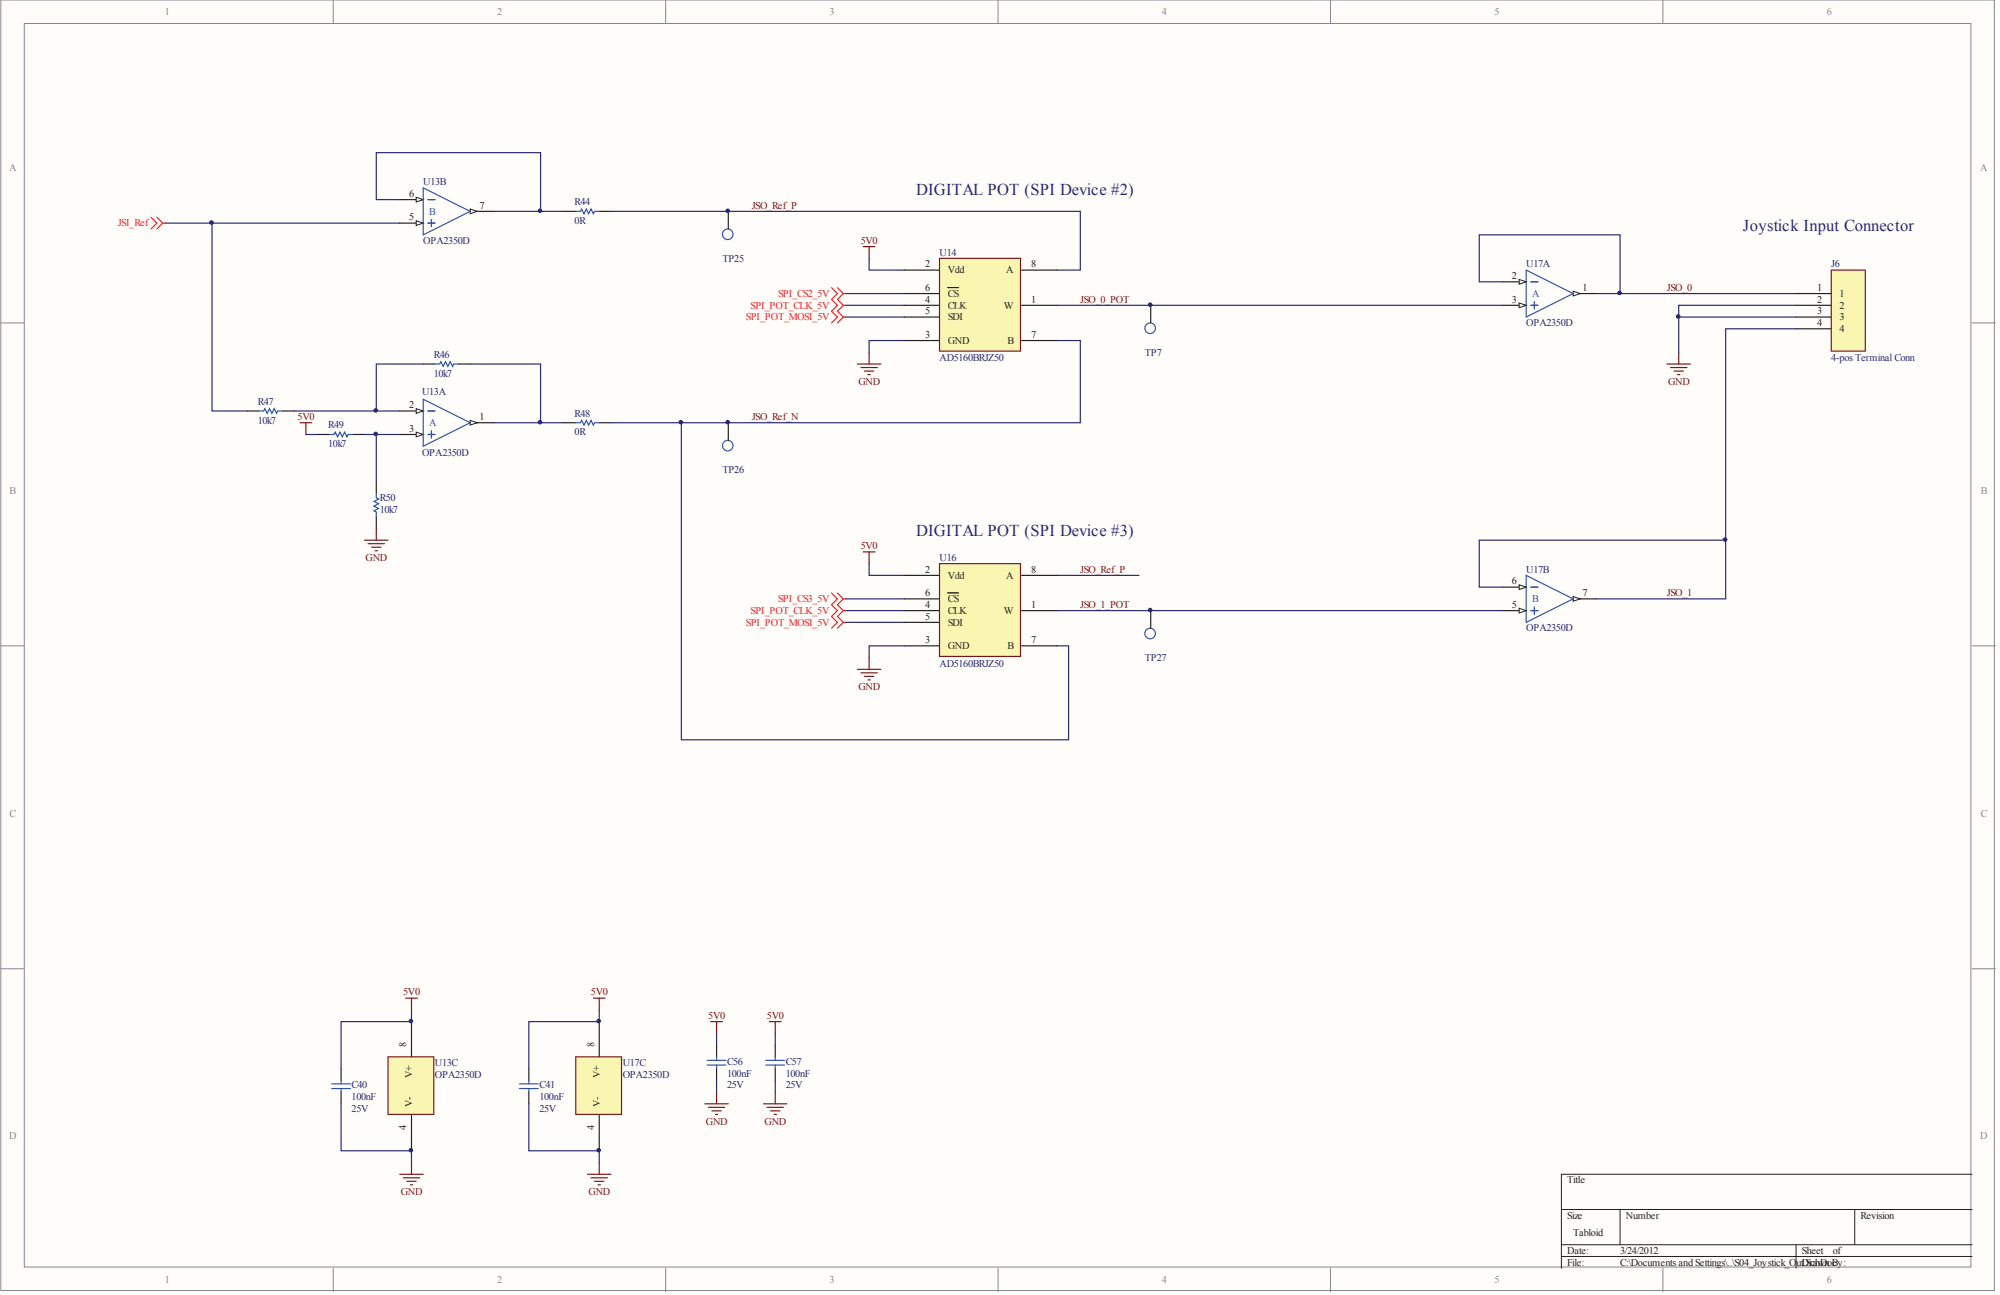
[picture p81: page 1]

DIGITAL POT (SPI Device #3)
