ipeet/mte481/doc/final/appendices/FYDP_Schematic_Sheet_5.pdf

## Sonar Connector #1

## ADC (SPI Device #1)

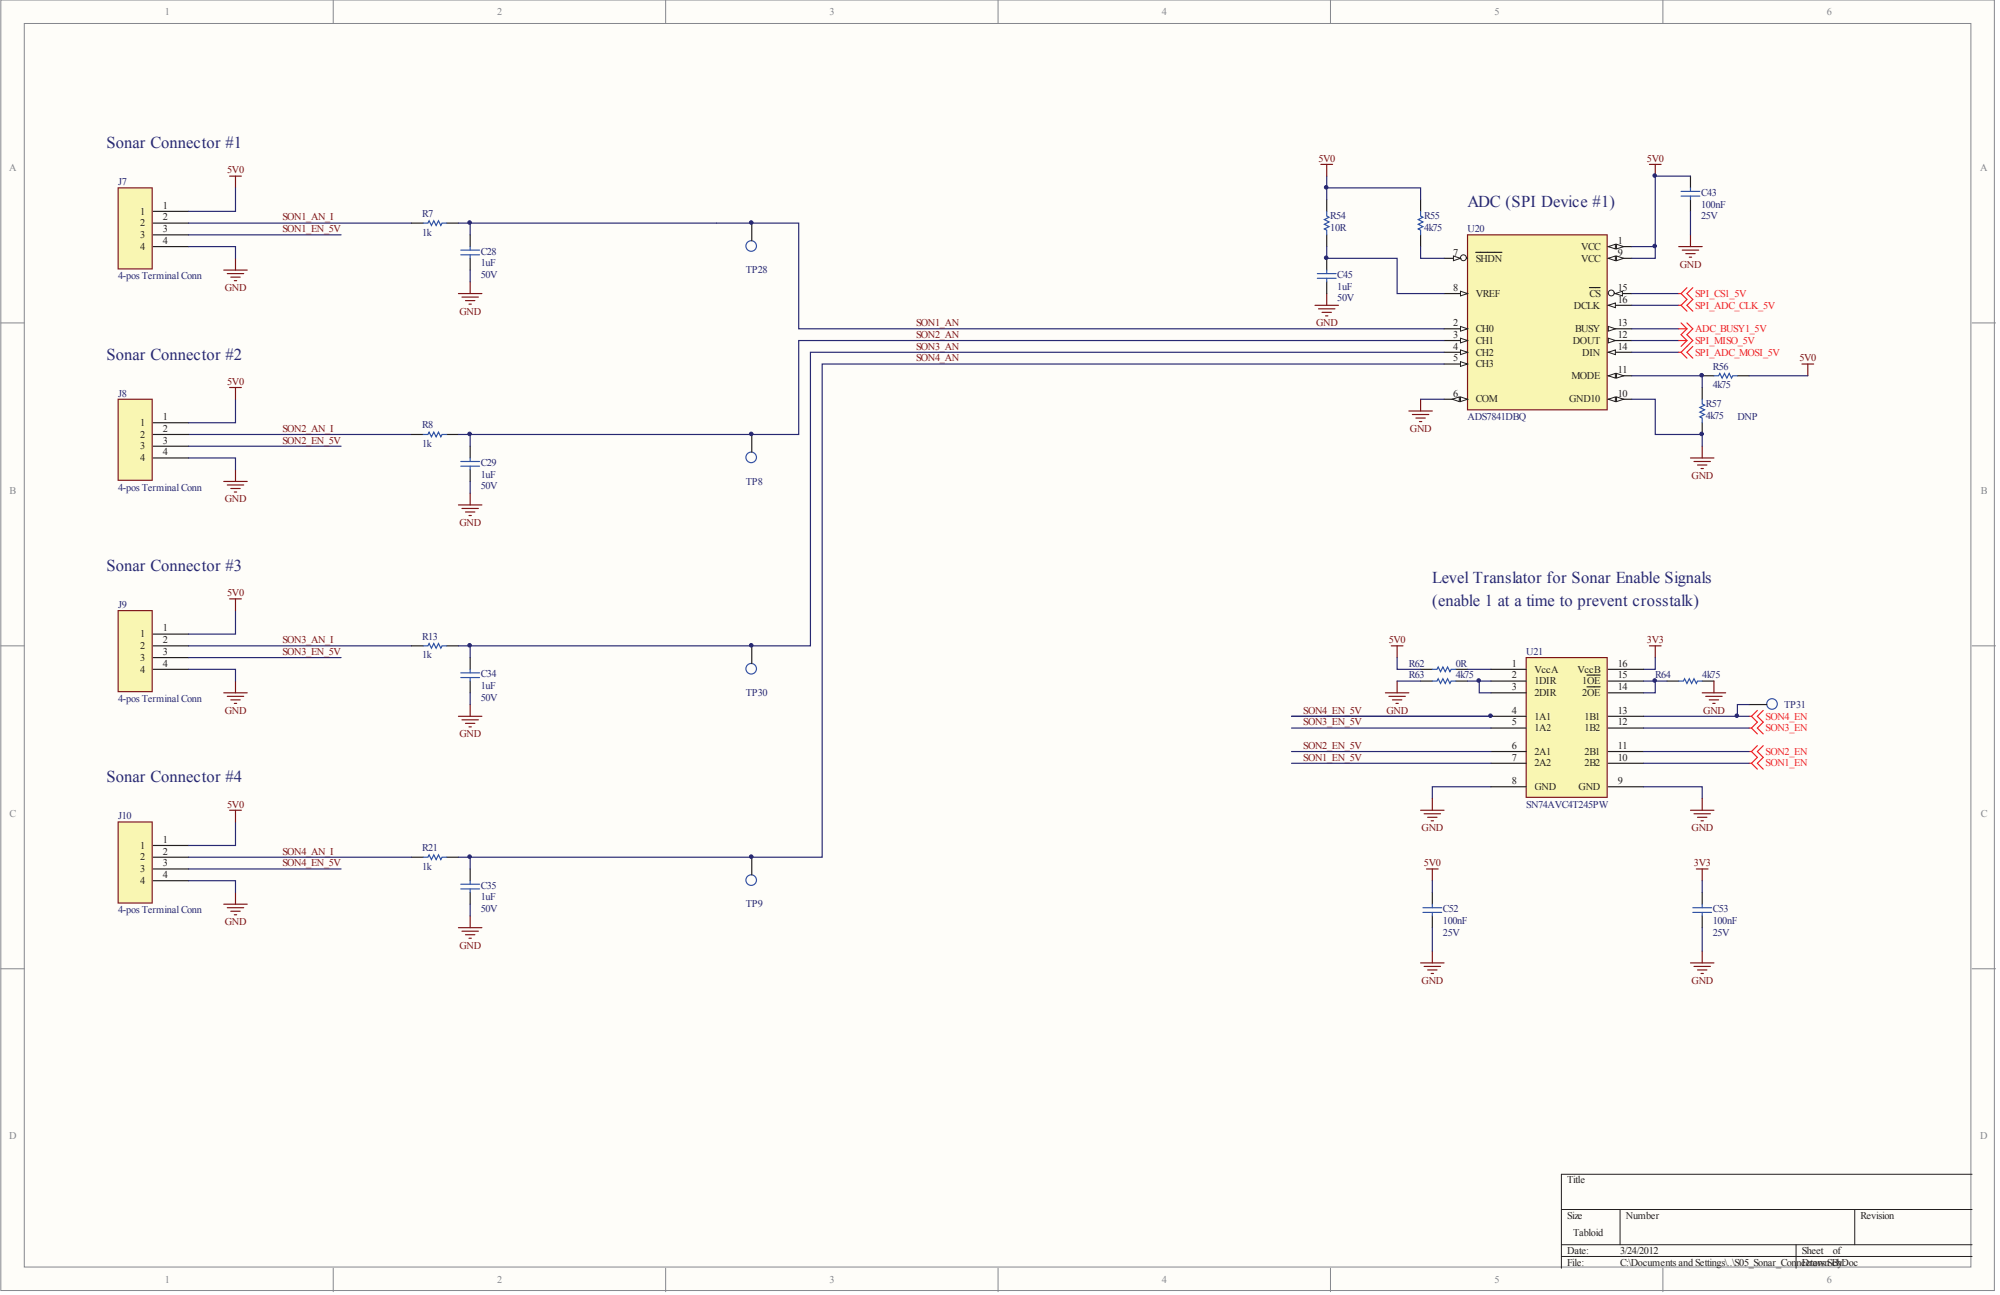
[picture p82: page 1]

Level Translator for Sonar Enable Signals
(enable 1 at a time to prevent crosstalk)
