ipeet/mte481/doc/report/images/gantt.pdf

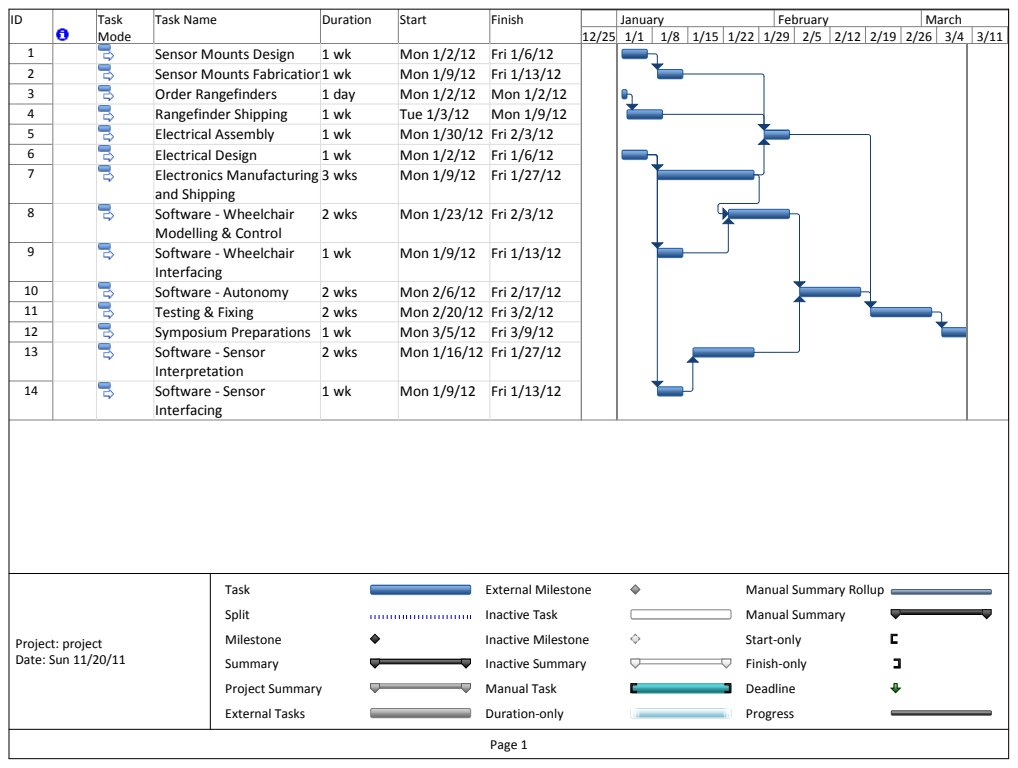
[picture p83: page 1]
Start-only; Finish-only; Deadline; Progress

ID | | Task Mode | Task Name | Duration | Start | Finish | | January | February | March

1 | | | Sensor Mounts Design | 1 wk | Mon 1/2/12 | Fri 1/6/12
2 | | | Sensor Mounts Fabrication1 wk | | Mon 1/9/12 | Fri 1/13/12
3 | | | Order Rangefinders | 1 day | Mon 1/2/12 | Mon 1/2/12
4 | | | Rangefinder Shipping | 1 wk | Tue 1/3/12 | Mon 1/9/12
5 | | | Electrical Assembly | 1 wk | Mon 1/30/12 | Fri 2/3/12
6 | | | Electrical Design | 1 wk | Mon 1/2/12 | Fri 1/6/12
7 Electronics Manufacturing | | | and Shipping | 3 wks | Mon 1/9/12 | Fri 1/27/12

8 Software - Wheelchair | | | Modelling & Control | 2 wks | Mon 1/23/12 | Fri 2/3/12

9 Software - Wheelchair | | | Interfacing | 1 wk | Mon 1/9/12 | Fri 1/13/12

10 | | | Software - Autonomy | 2 wks | Mon 2/6/12 | Fri 2/17/12
11 | | | Testing & Fixing | 2 wks | Mon 2/20/12 | Fri 3/2/12
12 | | | Symposium Preparations | 1 wk | Mon 3/5/12 | Fri 3/9/12
13 Software - Sensor | | | Interpretation | 2 wks | Mon 1/16/12 | Fri 1/27/12

14 Software - Sensor | | | Interfacing | 1 wk | Mon 1/9/12 | Fri 1/13/12

Project: project Date: Sun 11/20/11 | Task External Milestone Split Inactive Task Milestone Inactive Milestone Summary Inactive Summary Project Summary Manual Task External Tasks Duration-only | Manual Summary Rollup Manual Summary

Page 1
