ipeet/mte481/wheelchair_ros/src/renderer.cpp

#include <GL/gl.h>
#include <GL/glu.h>
#include <GL/glut.h>
#include <iostream>

#include <nav_msgs/OccupancyGrid.h>
#include "wheelchair_ros/config.hpp"
#include "wheelchair_ros/renderer.hpp"
#include "wheelchair_ros/Occupancy3D.h"
#include "wheelchair_ros/geometry.hpp"

using namespace std;
using namespace wheelchair_ros;
using nav_msgs::OccupancyGrid;

void checkGLError(const char* file, int line) {
  GLenum err = glGetError();
  if (err != GL_NO_ERROR) {
    if (file) cerr << file << ":";
    if (line) cerr << line << ":";
    if (file || line) cerr << " ";
    cerr << gluErrorString(err) << endl;
  }
}
#define CHECK_GL() checkGLError(__FILE__, __LINE__)

const Quaternion RendererView::DEFAULT_ROTATION (30.0*M_PI/180.0, Vector3D(1, 0, 0));
const Vector3D RendererView::DEFAULT_TRANSLATION (0, 0, -100);

void RendererView::reset() {
  m_rotation = DEFAULT_ROTATION;
  m_translation = DEFAULT_TRANSLATION;
}

Renderer::Renderer(int width, int height) :
  m_fov(60.0),
  m_width(width),
  m_height(height),
  m_cubeList(0),
  m_wfCubeList(0),
  m_driveEnabled(true),
  m_view(NULL)
{
  glShadeModel(GL_SMOOTH);
  glClearColor(0, 0, 0, 0);
  glEnable(GL_DEPTH_TEST);
  CHECK_GL();
}

void Renderer::render() {
  glClear(GL_COLOR_BUFFER_BIT | GL_DEPTH_BUFFER_BIT);
  glEnable(GL_NORMALIZE);
  glEnable(GL_DEPTH_TEST);
  glEnable(GL_CULL_FACE);
  glCullFace(GL_BACK);

  glMatrixMode(GL_PROJECTION);
  glLoadIdentity();
  glViewport(0, 0, m_width, m_height);
  gluPerspective(m_fov, double(m_width)/m_height, 0.1, 1000.0);
  CHECK_GL();

  glMatrixMode(GL_MODELVIEW);
  glLoadIdentity();

  /* Lighting */
  glEnable(GL_LIGHTING);
  GLfloat pos[] = {0, 0, 0, 1.0};
  glLightfv(GL_LIGHT1, GL_POSITION, pos);
  GLfloat light[] = {0.7, 0.7, 0.7};
  GLfloat dark[] = {0, 0, 0};
  glLightfv(GL_LIGHT1, GL_AMBIENT, dark);
  glLightfv(GL_LIGHT1, GL_DIFFUSE, light);
  glLightfv(GL_LIGHT1, GL_SPECULAR, light);
  glEnable(GL_LIGHT1);

  /* Transform co-ordinates and render */
  glPushMatrix();
  if (m_view) {
    glTranslated(m_view->m_translation.v[0], m_view->m_translation.v[1], 
        m_view->m_translation.v[2]);
    glRotated(m_view->m_rotation.angle() * 180.0 / M_PI,
        m_view->m_rotation.x(), m_view->m_rotation.y(), m_view->m_rotation.z());
    m_view->render();
  } else {
    glTranslated(-0.5, 0, -10);
    glRotated(30, 1, 0, 0);
    glRotated(30, 0, 1, 0);
    drawWfCube();
  }

  glPopMatrix();
  CHECK_GL();


  /* Switch to orthographic projection to draw text */
  glMatrixMode(GL_PROJECTION);
  glLoadIdentity();
  glOrtho(0, m_width, 0, m_height,-1.0,1.0);

  glDisable(GL_LIGHTING);
  glColor3f(1,0,0);
  if (!m_driveEnabled) {
    drawString("Drive Disabled.", 10.0, 10.0);
  }
  CHECK_GL();

  glutSwapBuffers();
}

void Renderer::drawString(const char* str, double x, double y, double z) {
  glRasterPos3f(x, y, z);
  while (*str) {
    glutBitmapCharacter(GLUT_BITMAP_HELVETICA_18, *str);
    str++;
  }
}

void Renderer::setViewport(int w, int h) {
  m_width = w;
  m_height = h;
}

Quaternion Renderer::getRotation() const {
  if (m_view) {
    return m_view->m_rotation;
  } else {
    return Quaternion();
  }
}

void Renderer::setRotation(const Quaternion& q) {
  if (m_view) {
    m_view->m_rotation = q;
  } 
}

Vector3D Renderer::getTranslation() const {
  if (m_view) {
    return m_view->m_translation;
  } else {
    return Vector3D();
  }
}

void Renderer::setTranslation(const Vector3D &v) {
  if (m_view) {
    m_view->m_translation = v;
  }
}

void Renderer::reset() {
  m_view->reset();
}

void Renderer::drawCube() {
  if (!m_cubeList) {
    createCubeDisplayList();
  }
  glCallList(m_cubeList);
  CHECK_GL();
}

void Renderer::drawWfCube() {
  /* Back wall */
  glBegin(GL_LINE_LOOP);
  glVertex3d(-0.5,-0.5,0.5);
  glVertex3d(0.5,-0.5,0.5);
  glVertex3d(0.5,0.5,0.5);
  glVertex3d(-0.5,0.5,0.5);
  glEnd();

  /* Left wall */
  glBegin(GL_LINE_LOOP);
  glVertex3d(-0.5,-0.5,-0.5); 
  glVertex3d(-0.5,-0.5,0.5); 
  glVertex3d(-0.5,0.5,0.5); 
  glVertex3d(-0.5,0.5,-0.5); 
  glEnd();

  /* Right Wall */
  glBegin(GL_LINE_LOOP);
  glVertex3d(0.5,-0.5,-0.5); 
  glVertex3d(0.5,-0.5,0.5); 
  glVertex3d(0.5,0.5,0.5); 
  glVertex3d(0.5,0.5,-0.5); 
  glEnd();

  /* Front wall(ish) */
  glBegin(GL_LINE_LOOP);
  glVertex3d(-0.5,-0.5,-0.5);
  glVertex3d(0.5,-0.5,-0.5);
  glVertex3d(0.5,0.5,-0.5);
  glVertex3d(-0.5,0.5,-0.5);
  glEnd();

  CHECK_GL();
}

void Renderer::drawQuad(double x, double y) {
  glPushMatrix();
  glTranslated(x, y, 0);
  glScaled(0.9, 0.9, 0);
  glBegin(GL_QUADS);
  glNormal3d(0, 0, 1);
  glVertex3d(-0.5, -0.5, 0);
  glVertex3d(0.5, -0.5, 0);
  glVertex3d(0.5, 0.5, 0);
  glVertex3d(-0.5, 0.5, 0);
  glEnd();
  glPopMatrix();
  CHECK_GL();
}

void Renderer::drawPoly(const Polygon& poly) {
  glBegin(GL_LINE_LOOP);
  for (unsigned i=0; i < poly.size(); ++i) {
    glVertex3dv(poly[i].p);
  }
  glEnd();
  CHECK_GL();
}

void Renderer::createCubeDisplayList() {
  m_cubeList = glGenLists(1);
  if (! m_cubeList) {
    cerr << "Failed to allocate display list." << endl;
    cerr << "GL: " << gluErrorString(glGetError()) << endl;
    abort();
  }

  glNewList(m_cubeList, GL_COMPILE);
  glBegin(GL_QUADS);
  /* xy faces */
  glNormal3d(0, 0, 1);
  glVertex3d(-0.5, -0.5, 0.5);
  glVertex3d(0.5, -0.5, 0.5);
  glVertex3d(0.5, 0.5, 0.5);
  glVertex3d(-0.5, 0.5, 0.5);

  glNormal3d(0, 0, -1);
  glVertex3d(0.5, -0.5, -0.5);
  glVertex3d(-0.5, -0.5, -0.5);
  glVertex3d(-0.5, 0.5, -0.5);
  glVertex3d(0.5, 0.5, -0.5);

  /* yz faces */
  glNormal3d(1, 0, 0);
  glVertex3d(0.5, -0.5, -0.5);
  glVertex3d(0.5, 0.5, -0.5);
  glVertex3d(0.5, 0.5, 0.5);
  glVertex3d(0.5, -0.5, 0.5);

  glNormal3d(-1, 0, 0);
  glVertex3d(-0.5, -0.5, 0.5);
  glVertex3d(-0.5, 0.5, 0.5);
  glVertex3d(-0.5, 0.5, -0.5);
  glVertex3d(-0.5, -0.5, -0.5);

  /* xz faces */
  glNormal3d(0, 1, 0);
  glVertex3d(0.5, 0.5, -0.5);
  glVertex3d(-0.5, 0.5, -0.5);
  glVertex3d(-0.5, 0.5, 0.5);
  glVertex3d(0.5, 0.5, 0.5);

  glNormal3d(0, -1, 0);
  glVertex3d(-0.5, -0.5, -0.5);
  glVertex3d(0.5, -0.5, -0.5);
  glVertex3d(0.5, -0.5, 0.5);
  glVertex3d(-0.5, -0.5, 0.5);

  glEnd();
  glEndList();
}

void Map3DView::setMap(const wheelchair_ros::Occupancy3D::ConstPtr &msg) {
  m_haveMap = true;
  m_map = msg;
}

void Map3DView::setPath(const wheelchair_ros::PredictedPath::ConstPtr &msg) {
  m_havePath = true;
  m_path = msg;
}

void Map3DView::render() {
  glPushMatrix();

  /* convenience */
  int w, d, h;
  if (m_haveMap) {
    w = m_map->width;
    d = m_map->depth;
    h = m_map->height;
  } else {
    w = config::WIDTH / config::RESOLUTION;
    d = config::DEPTH / config::RESOLUTION;
    h = config::HEIGHT / config::RESOLUTION;
  }

  // X offset to algin the centre the map's depth axis.
  glTranslated(-0.5*w, -0.5*h, 0.5*d);

  drawBounds(w, h, -d);
  drawMap();
  drawPath();

  glPopMatrix();
  CHECK_GL();
}

void Map3DView::drawMap() {
  if (!m_haveMap) return;

  /* convenience */
  int w = m_map->width;
  int d = m_map->depth;
  int h = m_map->height;
  GLfloat white[] = {1.0, 1.0, 1.0, 1.0};
  GLfloat black[] = {0, 0, 0, 1};

  glMaterialfv(GL_FRONT, GL_AMBIENT_AND_DIFFUSE, white);
  glMaterialfv(GL_FRONT, GL_SPECULAR, white);
  glMaterialfv(GL_FRONT, GL_EMISSION, black);
  glMaterialf(GL_FRONT, GL_SHININESS, 20.0);
  for (int x=0; x < w; ++x) {
    for (int z=0; z < d; ++z) {
      for (int y=0; y < h; ++y) {
         int data = m_map->data[d*w*y + w*z + x];
         if (data) {
           glPushMatrix();
           glTranslated(x, y, -z);
           glScaled(0.9,0.9,0.9);
           m_renderer.drawCube();
           glPopMatrix();
         }
      }
    }
  }
}

void Map3DView::drawPath() {
  /* convenience */
  GLfloat black[] = {0, 0, 0, 1};
  GLfloat green[] = {0, 1, 0, 1};
  GLfloat red[] = {1, 0, 0, 1};

  glPushMatrix();
  /* Map to physics co-ordinate space */
  glScaled(1.0/config::RESOLUTION, 1.0/config::RESOLUTION, 1.0/config::RESOLUTION);
  glTranslated(-config::ORIG_X, 0.5, config::ORIG_Z); 

  /* Draw the start point */
  glPushMatrix();
  glScaled(config::WHEELCHAIR_WIDTH, 1.0, config::WHEELCHAIR_LENGTH);
  glMaterialfv(GL_FRONT, GL_AMBIENT_AND_DIFFUSE, black);
  glMaterialfv(GL_FRONT, GL_SPECULAR, black);
  glMaterialfv(GL_FRONT, GL_EMISSION, green);
  m_renderer.drawWfCube();
  glPopMatrix();

  /* Draw the path */
  if (!m_havePath) {
    glPopMatrix();
    return;
  }

  glMaterialfv(GL_FRONT, GL_AMBIENT_AND_DIFFUSE, green);
  glMaterialfv(GL_FRONT, GL_SPECULAR, black);
  glMaterialfv(GL_FRONT, GL_EMISSION, black);

  for (int i=0; (i+1) < m_path->poses.size(); ++i) {
    double x1 = m_path->poses[i].pose.position.x;
    double y1 = m_path->poses[i].pose.position.y;
    double x2 = m_path->poses[i+1].pose.position.x;
    double y2 = m_path->poses[i+1].pose.position.y;
    double len = sqrt((x2-x1)*(x2-x1) + (y2-y1)*(y2-y1));
    double th = atan2((y2-y1),(x2-x1));

    glPushMatrix();
    // Place link at (x1, y1) */
    glTranslated(x1, 0, -y1);
    // Scale and rotate link it so it reaches (x2, y2) 
    glRotated(180.0*th/M_PI, 0, 1, 0);
    glScaled(len, 0.1, 0.1);
    glTranslated(0.5, 0, 0);
    m_renderer.drawCube();
    glPopMatrix();
  }

  /* Draw the end point */
  glPushMatrix();
  glMaterialfv(GL_FRONT, GL_AMBIENT_AND_DIFFUSE, black);
  glMaterialfv(GL_FRONT, GL_SPECULAR, black);
  if (m_path->poseCollides.back()) {
    glMaterialfv(GL_FRONT, GL_EMISSION, red);
  } else {
    glMaterialfv(GL_FRONT, GL_EMISSION, green);
  }
  glTranslated(m_path->poses.back().pose.position.x, 0,
      - m_path->poses.back().pose.position.y);
  glRotated(180.0*m_path->poses.back().pose.orientation.w / M_PI, 
      0, 1, 0);
  glScaled(config::WHEELCHAIR_LENGTH, 1.0, config::WHEELCHAIR_WIDTH);
  m_renderer.drawWfCube();
  glPopMatrix();

  glPopMatrix();
}

void Map3DView::drawBounds(double x, double y, double z) {
  GLfloat em[] = {0.0, 0.0, 0.5, 1.0};
  GLfloat blk[] = {0, 0, 0, 0};
  glMaterialfv(GL_FRONT, GL_AMBIENT_AND_DIFFUSE, blk);
  glMaterialfv(GL_FRONT, GL_SPECULAR, blk);
  glMaterialfv(GL_FRONT, GL_EMISSION, em);

  /* Back wall */
  glBegin(GL_LINE_LOOP);
  glVertex3d(0,0,z);
  glVertex3d(x,0,z);
  glVertex3d(x,y,z);
  glVertex3d(0,y,z);
  glEnd();

  /* Left wall */
  glBegin(GL_LINE_LOOP);
  glVertex3d(0,0,0); 
  glVertex3d(0,0,z); 
  glVertex3d(0,y,z); 
  glVertex3d(0,y,0); 
  glEnd();

  /* Right Wall */
  glBegin(GL_LINE_LOOP);
  glVertex3d(x,0,0); 
  glVertex3d(x,0,z); 
  glVertex3d(x,y,z); 
  glVertex3d(x,y,0); 
  glEnd();

  /* Front wall(ish) */
  glBegin(GL_LINES);
  glVertex3d(0,0,0);
  glVertex3d(x,0,0);
  glEnd();

  GLfloat no_em[] = {0, 0, 0, 0};
  glMaterialfv(GL_FRONT, GL_EMISSION, no_em);
  CHECK_GL();
}

void CollisionView::reset() {
  m_rotation = Quaternion();
  m_translation = RendererView::DEFAULT_TRANSLATION;
}

void CollisionView::setMap(const OccupancyGrid::ConstPtr &msg) {
  m_map = msg;
  m_haveMap = true;
}

void CollisionView::setPath(const PredictedPath::ConstPtr &msg) {
  m_path = msg;
  m_havePath = true;
}

void CollisionView::render() {
  glPushMatrix();

  double w, h;
  if (m_haveMap) {
    w = m_map->info.width;
    h = m_map->info.height;
  } else {
    w = 40;
    h = 40;
  }

  /* Invert the default rotations.  The means that map will be viewed head-on
   * if view hasn't been modified, but will retain any delta */
  glTranslated(-0.5*w, -0.5*h, 0);

  /* Draw the bouding rectangle */
  GLfloat em[] = {0, 0, 0.8, 1};
  GLfloat blk[] = {0, 0, 0, 1};
  glMaterialfv(GL_FRONT, GL_AMBIENT_AND_DIFFUSE, blk);
  glMaterialfv(GL_FRONT, GL_SPECULAR, blk);
  glMaterialfv(GL_FRONT, GL_EMISSION, em);
  glBegin(GL_LINE_LOOP);
  glVertex3d(-0.5, -0.5, 0);
  glVertex3d(w-0.5, -0.5, 0);
  glVertex3d(w-0.5, h-0.5, 0);
  glVertex3d(-0.5, h-0.5, 0);
  glEnd();

  renderMap();
  renderPath();
  glPopMatrix();
  CHECK_GL();
}

void CollisionView::renderMap() {
  if (!m_haveMap) return;
  double w = m_map->info.width;
  double h = m_map->info.height;

  /* Draw the actual map */
  GLfloat diff[] = {1.0, 1.0, 1.0, 1.0};
  GLfloat spec[] = {1.0, 1.0, 1.0, 1.0};
  GLfloat blk[] = {0, 0, 0, 1};
  glMaterialfv(GL_FRONT, GL_AMBIENT_AND_DIFFUSE, diff);
  glMaterialfv(GL_FRONT, GL_SPECULAR, spec);
  glMaterialfv(GL_FRONT, GL_EMISSION, blk);
  glMaterialf(GL_FRONT, GL_SHININESS, 25.0);
  for (int i=0; i < w; ++i) {
    for (int j=0; j < h; ++j) {
      if (m_map->data[j*w + i]) {
        m_renderer.drawQuad(i, j);
      }
    }
  }
}

void CollisionView::renderPath() {
  if (!m_havePath) return;

  Polygon wheelPoly (config::getWheelchairBounds());
  double orig_x = -20.0;
  double orig_y = -20.0;
  double res = 0.1;
  if (m_haveMap) {
    orig_x = m_map->info.origin.position.x;
    orig_y = m_map->info.origin.position.y;
    res = m_map->info.resolution;
  }

  glPushMatrix();
  glScaled(1.0/res, 1.0/res, 1.0);
  glTranslated(-orig_x, -orig_y, 0.05);

  GLfloat green[] = {0, 1, 0, 1};
  GLfloat red[] = {1, 0, 0, 1};
  GLfloat blk[] = {0, 0, 0, 1};
  glMaterialfv(GL_FRONT, GL_AMBIENT_AND_DIFFUSE, blk);
  glMaterialfv(GL_FRONT, GL_SPECULAR, blk);
  glMaterialfv(GL_FRONT, GL_EMISSION, green);

  glBegin(GL_LINES);
  for (unsigned i=1; i < m_path->poses.size(); ++i) {
    glVertex3d( m_path->poses[i-1].pose.position.x, 
                m_path->poses[i-1].pose.position.y - config::KINECT_OFFSET,
                0.0 );
    glVertex3d( m_path->poses[i].pose.position.x, 
                m_path->poses[i].pose.position.y - config::KINECT_OFFSET,
                0.0 );
  }
  glEnd();
  CHECK_GL();

  for (unsigned i=0; i < m_path->poses.size(); ++i) {
    glPushMatrix();
    if (m_path->poseCollides[i]) {
      glMaterialfv(GL_FRONT, GL_EMISSION, red);
    } else {
      glMaterialfv(GL_FRONT, GL_EMISSION, green);
    }
    glTranslated(0, -config::KINECT_OFFSET, 0);
    glTranslated(m_path->poses[i].pose.position.x,
                 m_path->poses[i].pose.position.y,
                 0);
    glRotated(m_path->poses[i].pose.orientation.w * 180.0 / M_PI, 0, 0, 1);
    m_renderer.drawPoly(wheelPoly);
    glPopMatrix();
    CHECK_GL();
  }

  glPopMatrix();
  CHECK_GL();
}
