ipeet/mte481/wheelchair_ros/src/serial.cpp

/******************************************************************************
 * serial.cpp
 * Copyright 2011 Iain Peet
 *
 * Provides basic termios serial communication logic.
 ******************************************************************************
 * This program is distributed under the of the GNU Lesser Public License. 
 *
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
 * You should have received a copy of the GNU General Public License
 * along with this program.  If not, see <http://www.gnu.org/licenses/>
 *****************************************************************************/

#include <errno.h>
#include <fcntl.h>
#include <math.h>
#include <stdlib.h>
#include <stdio.h>
#include <string.h>
#include <termios.h>
#include <unistd.h>

#include "wheelchair_ros/serial.h"

Serial::Serial(const char* serialDev) : m_serialDev(serialDev), m_serialFd(-1)
{
  openSerial();
}

Serial::~Serial()
{
  closeSerial();
}

void Serial::openSerial()
{
  if (m_serialFd != -1) return; //already open.

  /* Open the serial dev */
  m_serialFd = open(m_serialDev, O_RDWR | O_NOCTTY);
  if (m_serialFd < 0) {
    throw new Exception(strerror(errno));
  }
  if (!isatty(m_serialFd)) {
    closeSerial();
    throw new Exception("Device is not a TTY.");
  }

  /* Set up serial config goop */
  struct termios serialTcAttr;
  if (tcgetattr(m_serialFd, &serialTcAttr)) {
    closeSerial();
    throw new Exception(strerror(errno));
  }
  m_initialTcAttr = serialTcAttr;
  serialTcAttr.c_iflag = 0;
  serialTcAttr.c_oflag = 0;
  serialTcAttr.c_cflag = CREAD | CLOCAL | CS8;
  serialTcAttr.c_lflag = 0;
  cfsetispeed(&serialTcAttr, B115200);
  cfsetospeed(&serialTcAttr, B115200);
  if (tcsetattr(m_serialFd, TCSANOW, &serialTcAttr)) {
    closeSerial();
    throw new Exception(strerror(errno));
  } 
}

void Serial::closeSerial()
{
  // NB: called by destructor, shouldn't throw exceptions.
  if (m_serialFd == -1) return; // already closed.

  if (tcsetattr(m_serialFd, TCSANOW, &m_initialTcAttr)) {
    perror("tcsetattr");
  }
  close(m_serialFd);
  m_serialFd = -1;
}

void Serial::setBlocking(bool blocking) {
  int flags = fcntl(m_serialFd, F_GETFL);
  if (flags == -1) {
    throw new Serial::Exception(strerror(errno));
  }
  if (blocking) {
    flags &= ~O_NONBLOCK;
  } else {
    flags |= O_NONBLOCK;
  }
  if (fcntl(m_serialFd, F_SETFL, flags)) {
    throw new Serial::Exception(strerror(errno));
  }
}

ssize_t Serial::send(const void* buf, size_t count) throw(Serial::Exception*) {
  ssize_t ret = write(m_serialFd, buf, count);
  if (ret == -1) {
    throw new Serial::Exception(strerror(errno));
  }
  return ret;
}

ssize_t Serial::receive(void* buf, size_t count) throw(Serial::Exception*) {
  ssize_t ret = read(m_serialFd, buf, count);
  if (ret == -1) {
    throw new Serial::Exception(strerror(errno));
  }
  return ret;
}
