ipeet/mte481/(commit log)

2011-10-02 Decided to track the pdf, for easy access
2011-10-02 Added sensor images / slides
2011-10-02 Changed laser sensor slide to LIDAR
2011-10-02 Cut some template cruft
2011-10-02 Added stub frames for patents
2011-10-03 Added Kinect sensor to presentation
2011-11-13 Adding the model to the folder, not yet complete
    [Wheel Chair Arms.SLDPRT, Wheel Chair Chair.SLDPRT, Wheel Chair Controller.SLDPRT, Wheel Chair Wheel.SLDPRT, Wheel Chair foot Rest.SLDPRT, Wheel Chair.SLDASM]
2011-11-13 Some refactoring, to use serial class for sonar
2011-11-13 Completed acquisition of sonar range data
2011-11-14 Made some changes model is now better, still need to make more change for a full model but this is good to show to the Ismail
    [Wheel Chair Arms.SLDPRT, Wheel Chair Chair.SLDPRT, Wheel Chair Controller.SLDPRT, Wheel Chair.SLDASM]
2011-11-19 New model for the presentation
    [Kinect.SLDPRT, Left End.SLDPRT, Right End.SLDPRT, Sonar Sensor.SLDPRT, Table.SLDPRT, Wheel Chair Arms.SLDPRT, Wheel Chair Chair.SLDPRT, Wheel Chair Wheel.SLDPRT]
2011-11-19 Did some work on a decision making matrix and a criteria tree along with some modeled pictures of the wheel chair.
    [Data.xlsx]
2011-11-20 Initial commit of PowerPoint Document.
2011-11-20 Moving tihngs around
    [Data.xlsx]
2011-11-20 Initial commit of digital camera photos from testing.
2011-11-27 Final powerpoint
2011-12-03 Added source files and images for report, cleaned up old directory.
    [Data.xlsx]
2011-12-03 Added Rowan's CAD reders to images directory
2011-12-03 Moved some sensor design sections into detailed design
2011-12-03 Added BOM to report.
2011-12-03 Checkpoint working on sensor configuration
2011-12-03 Added new Visio figure for Iain
    [BOM.xlsx]
2011-12-03 Add expected sonar results (requiring not-yet-existing image)
2011-12-03 Add NB for the BOM vs. price constraint
2012-01-21 Record colour palette we're currently using
2012-01-21 Added another page to the website, to track progress
2012-01-21 Initial cut at page layout and style.
2012-01-26 Implemented serial proto for ROS.
    Compiles. Not tested at all.
    Probably fails horribly.
    [protocol_dispatcher.cpp, protocol_handlers.cpp, serial.cpp, wheelchair_node.cpp]
2012-02-20 Added preliminary budget for project
    [Budget.xlsx]
2012-03-06 Switch kinect axes
2012-03-07 Change materials a bit
2012-03-08 Sort of working sonar - need sensor calibration
2012-03-08 Screenshot of the all sensors go.
2012-03-08 Add data acquisition to sensor launch files
2012-03-10 Fixed Renderer so it defers display list creation.
    [renderer.cpp, viewer_node.cpp]
2012-03-10 wheelchair_node now publishes joystick data
2012-03-13 wheelchair_node now retries if it can't open the serial device
2012-03-13 Add view switching, camera reset
    [renderer.cpp, viewer_node.cpp]
2012-03-13 Wired path predictions to viewer
2012-03-13 Added collision flags to path (nothing done yet)
    [controller.cpp, renderer.cpp, test_publisher.cpp, viewer_node.cpp]
2012-03-14 ROS wheelchair control: send zero whenever input received.
2012-03-14 Viewer draws wheelchair bounding box
2012-03-14 System functioning with collision check
    [controller.cpp, controller_node.cpp, geometry.cpp, occupancy.cpp, occupancy_node.cpp, renderer.cpp]
2012-03-15 Placed sonar properly
2012-03-15 Better use of sonar data, twiddling of sonar
2012-03-16 Improved camera view functions
2012-03-17 Updated website wheel chair render picture
    [Budget.xlsx]
2012-03-17 Add throttle nodes to launch files
2012-03-17 3D view now shows wheelchair trajectory
2012-03-19 Used wrong value for index limit. whoops
    [occupancy.cpp]
2012-03-20 Updated model to final version
    [Kinect.SLDPRT, Left End.SLDDRW, Left End.SLDPRT, RPM1.SLDPRT, RPM2.SLDPRT, Right End.SLDDRW, Right End.SLDPRT, Sonar Sensor.SLDPRT]
2012-03-23 Updated budget (should be final)
    [Budget.xlsx]
2012-03-24 Finished introduction section
    [Budget.xlsx]
2012-03-31 Updates to final report
    [BOM_Final.xlsx, Budget.xlsx]
2012-03-31 Case sensitivity
